Image-X-Institute/IntERAct/Documentation/6DoF/README.md

## **6DoF Platform Documentation**
* Robotic Motion Phantom Release updates                                 -   [RoboticMotionPhantom v2.0.0 Release.pdf](https://github.com/Image-X-Institute/6-DoF-Robotic-Motion-Phantom/blob/main/Documentation/6DoF/RoboticMotionPhantom%20v2.0.0%20Release.pdf)
* Bill of Materials                                                      -   [Bill of Materials.pdf](https://github.com/Image-X-Institute/6-DoF-Robotic-Motion-Phantom/blob/main/Documentation/6DoF/Bill%20of%20materials.pdf)
* UR3 robot specifications                                                -   [UR3 Robot specification](https://www.universal-robots.com/products/ur3-robot/)
* UR16 robot specifications                                               - [UR16 robot specification](https://www.universal-robots.com/products/ur16-robot/)
* CAD drawing of the phantom and tool flange holder                      -   [CAD Drawing of the phantom](https://github.com/Image-X-Institute/6-DoF-Robotic-Motion-Phantom/tree/main/Documentation/CAD%20Drawing%20of%20the%20phantom)
* MODBUS communication protocol                                          -   [MODBUS communication.pdf](https://github.com/Image-X-Institute/6-DoF-Robotic-Motion-Phantom/blob/main/Documentation/6DoF/MODBUS%20communication.pdf) and see [this link](https://www.universal-robots.com/articles/ur/modbus-server/).
* To set up the robotic motion phantom                                  -   [Getting Started UR16.pdf](https://github.com/Image-X-Institute/6-DoF-Robotic-Motion-Phantom/blob/main/Documentation/6DoF/Robotic%20phantom%20controller%20(UR16)%20instructions.pdf).
* To operate the robot using the software package                        -   [Software GUI guide.pdf](https://github.com/Image-X-Institute/6-DoF-Robotic-Motion-Phantom/blob/main/Documentation/6DoF/Software%20GUI%20Guide.pdf). 
* To perform QA tests for Kilovoltage Intrafraction Monitoring (KIM)     -   [KIM QA instructions using the robotic phantom](https://github.com/Image-X-Institute/6-DoF-Robotic-Motion-Phantom/blob/main/Documentation/6DoF/KIM%20QA%20Instructions.pdf)) and the QA analysis codes can be found here: https://github.com/ChandrimaSengupta/KIM-QA-Analysis/tree/main/KIM-QA-Analysis-master
* Tool Configuration: TCP, orientation, payload & center of gravity      -    https://www.youtube.com/watch?v=YnC-ccytJlw

## **Troubleshooting**
* As the IntERAct device (specifically, the 6DoF robot) uses TCP/IP protocol to communicate with the motion control software, Bluetooth devices (e.g. headphones, wireless mouse or keyboard) cannot be connected to the computer when motion control software is in use - this is because the motion control software code loops through all serial port connections to find the component platforms. **Please ensure no devices are connected via Bluetooth when running the motion control software/IntERAct device.**
