Image-X-Institute/IntERAct/Documentation/CAD Drawing of the phantom/README.md

This folder contains CAD designs of the phantom with a detector and without a detector attached to the tool tip of the robot and and the CAD design of the tool flange holder.
