Image-X-Institute/IntERAct/Documentation/6DoF/RoboticMotionPhantom v2.0.0 Release.pdf

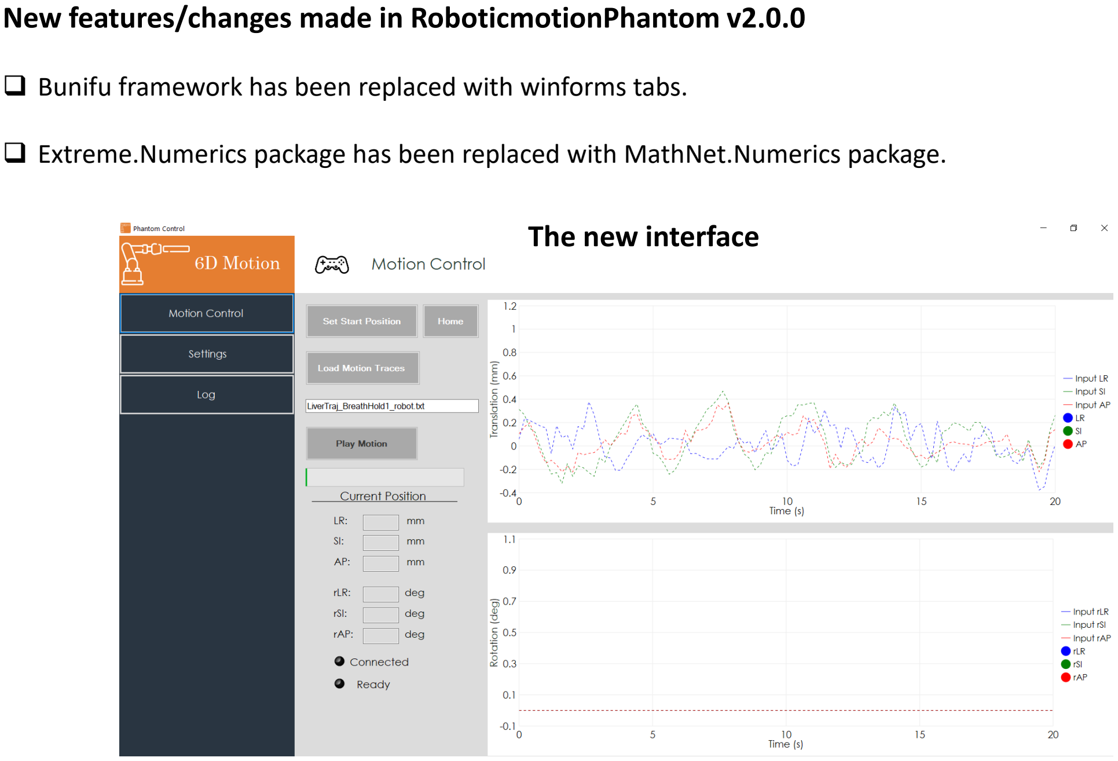
[picture p3: page 1]

New features/changes made in RoboticmotionPhantom v2.0.0

☐ Bunifu framework has been replaced with winforms tabs.

☐ Extreme.Numerics package has been replaced with MathNet.Numerics package.

The new interface

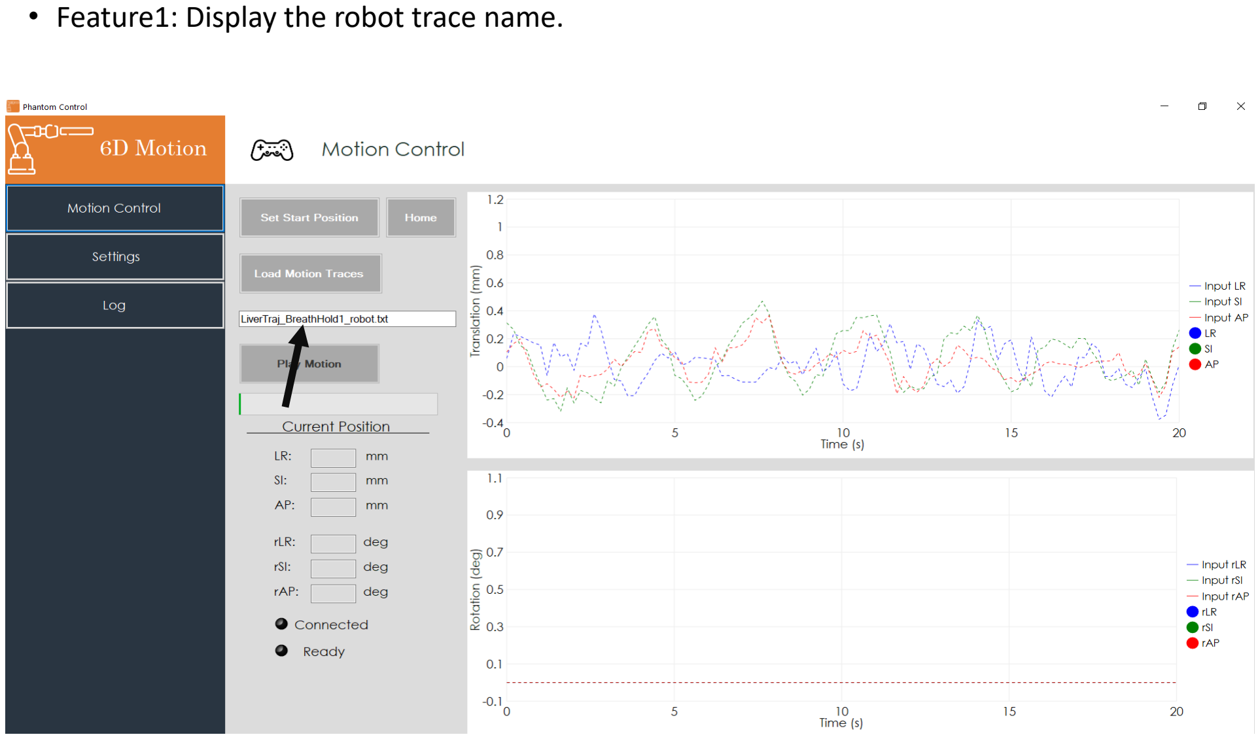
[picture p4: page 2]

- Feature1: Display the robot trace name.

- Feature2: The software will show an error if the Home button was not clicked before loading a new trace.

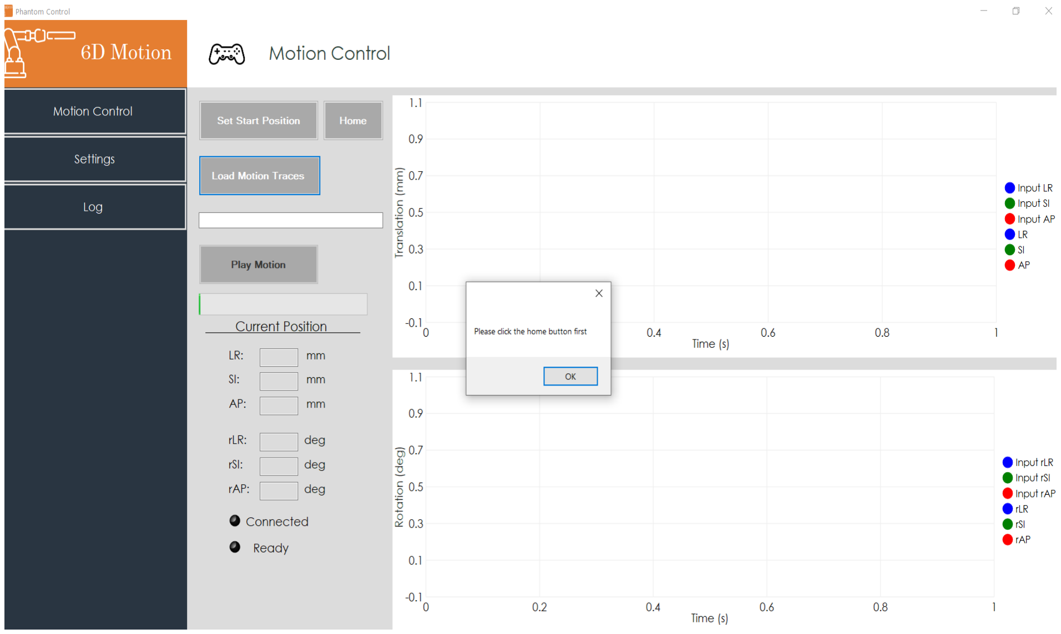
[picture p5: figure]

- Feature3: The software will show an error if the input frequency in the robot trace and in the settings are different.

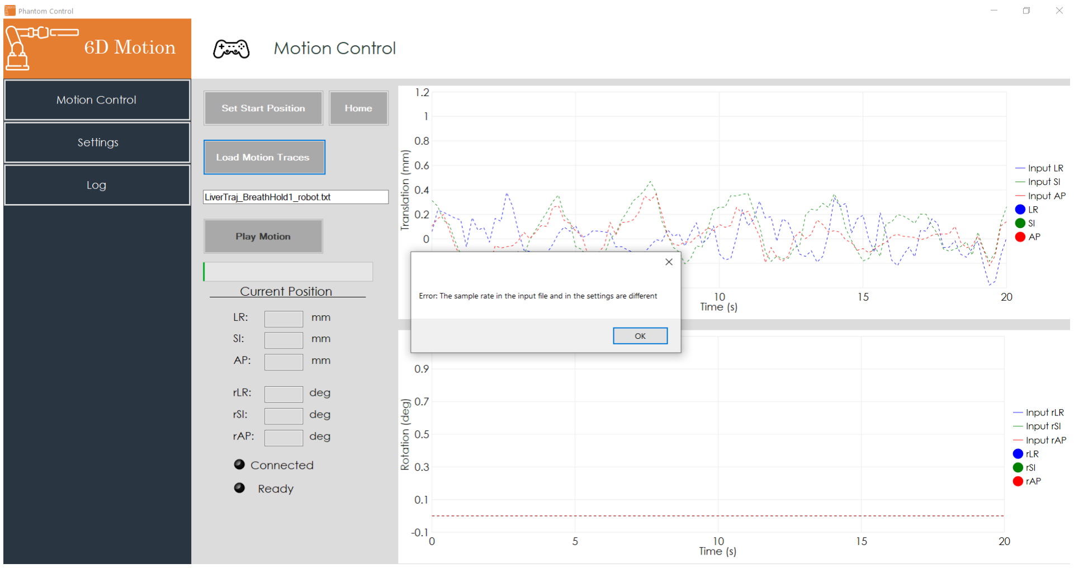
[picture p6: figure]
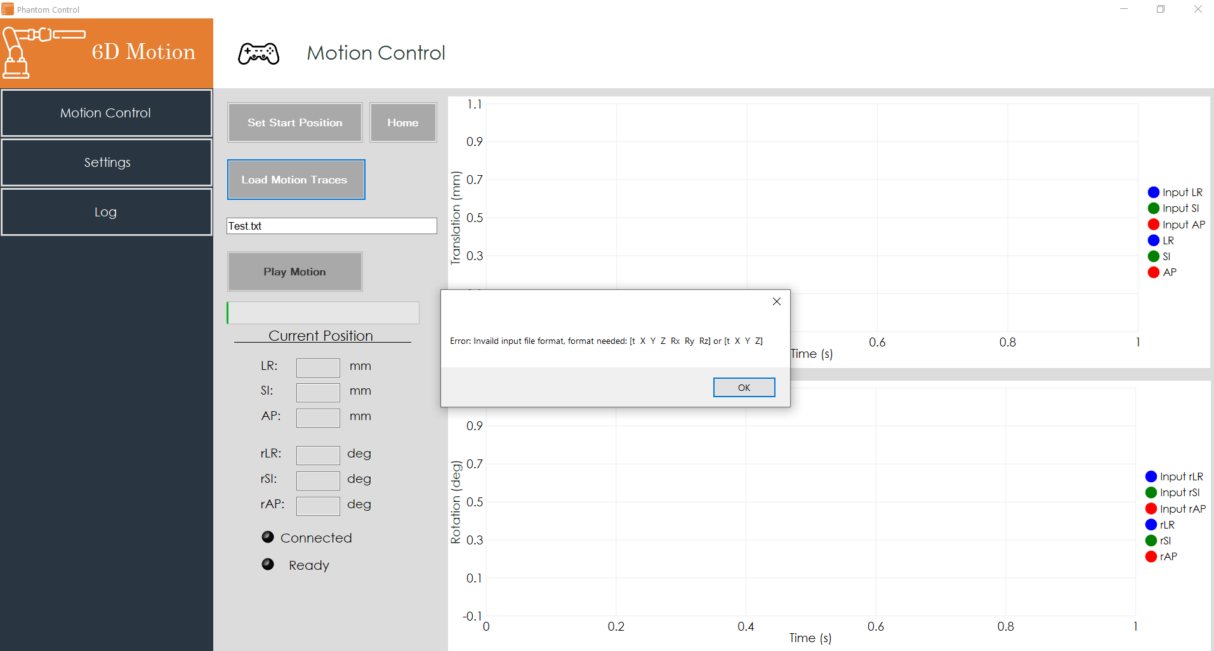
[picture p7: page 5]

- Feature4: The software will show an error if the robot trace file format is wrong.

- Feature5: Only shows the .txt files in the chosen folder.
- Feature 6: Shows the correct percentage of the progress.
- Feature 7: Adds a 5 mm boundary from the maximum magnitude of motion in all the three directions. Any displacement larger than that will stop the robot. This has been added as an additional safety check.
