Image-X-Institute/IntERAct/Documentation/6DoF/Robot Transport Checklist.jpg

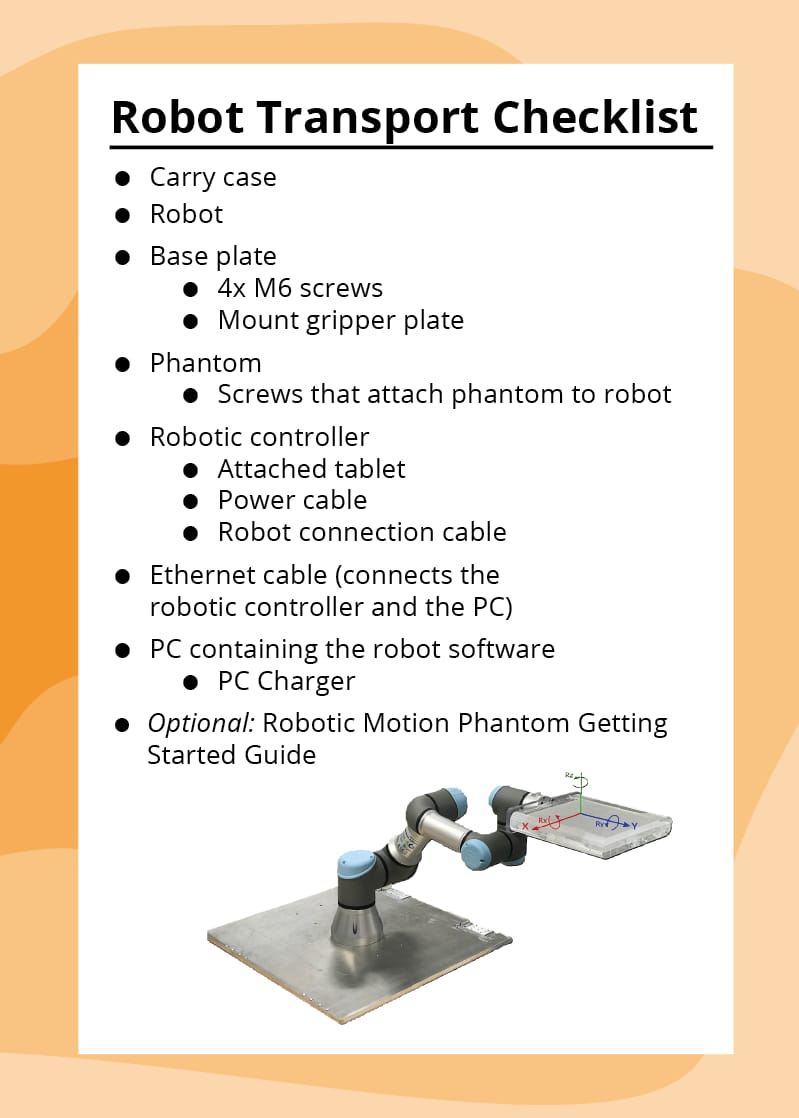
Documentation/6DoF/Robot Transport Checklist.jpg
