Image-X-Institute/IntERAct/Traces/LARK & SABR TRACES/13.02.24 LARK & SABR/LIGHT_SABR_traces/TraceImages/High_motion_Internal.jpg

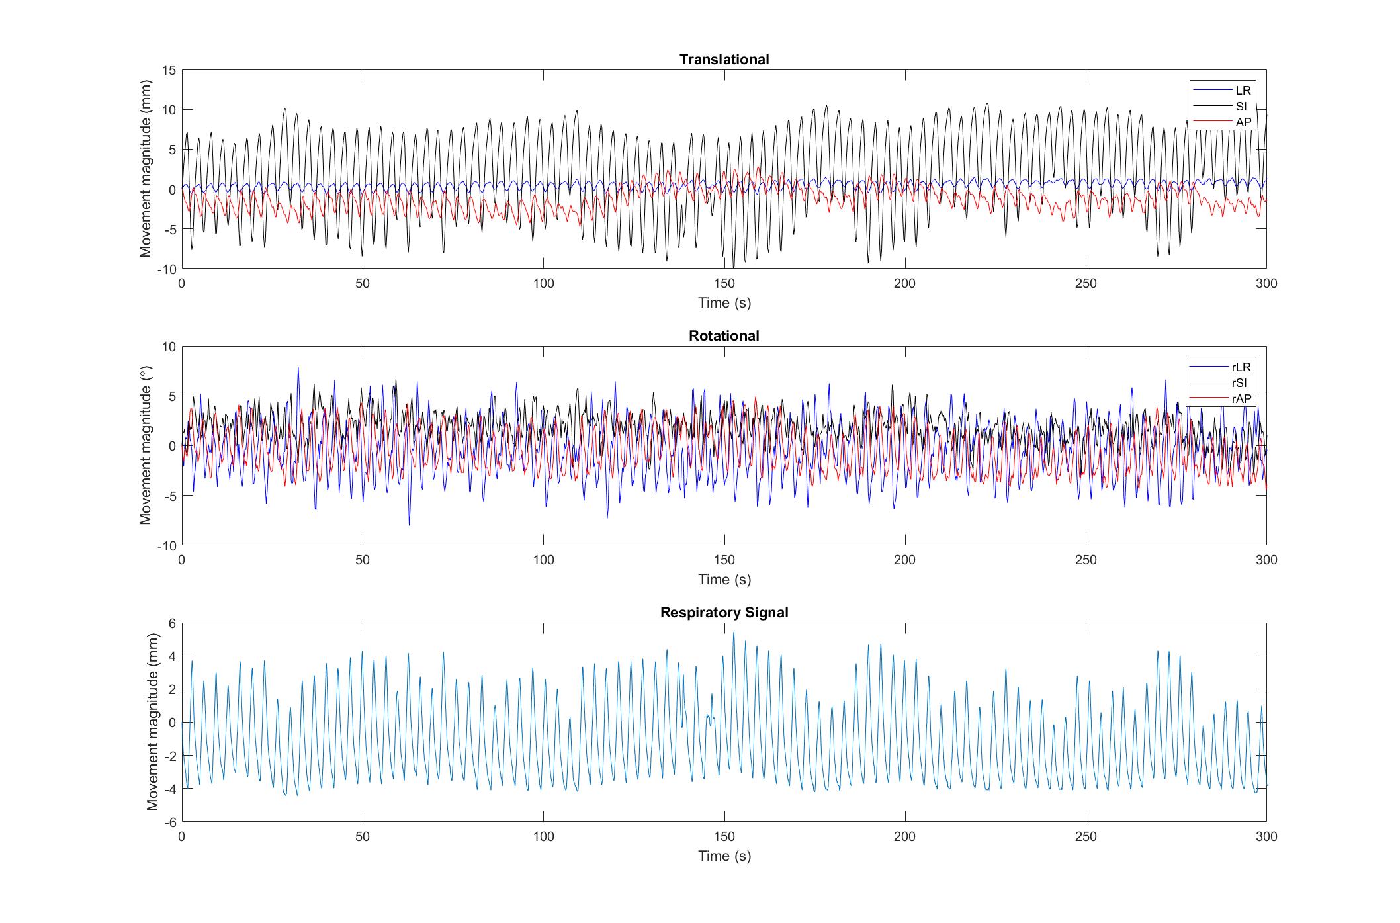
Traces/LARK & SABR TRACES/13.02.24 LARK & SABR/LIGHT_SABR_traces/TraceImages/High_motion_Internal.jpg
