Image-X-Institute/IntERAct/Traces/LARK & SABR TRACES/13.02.24 LARK & SABR/LIGHT_SABR_traces/TraceImages/Mean_complexity_Internal.jpg

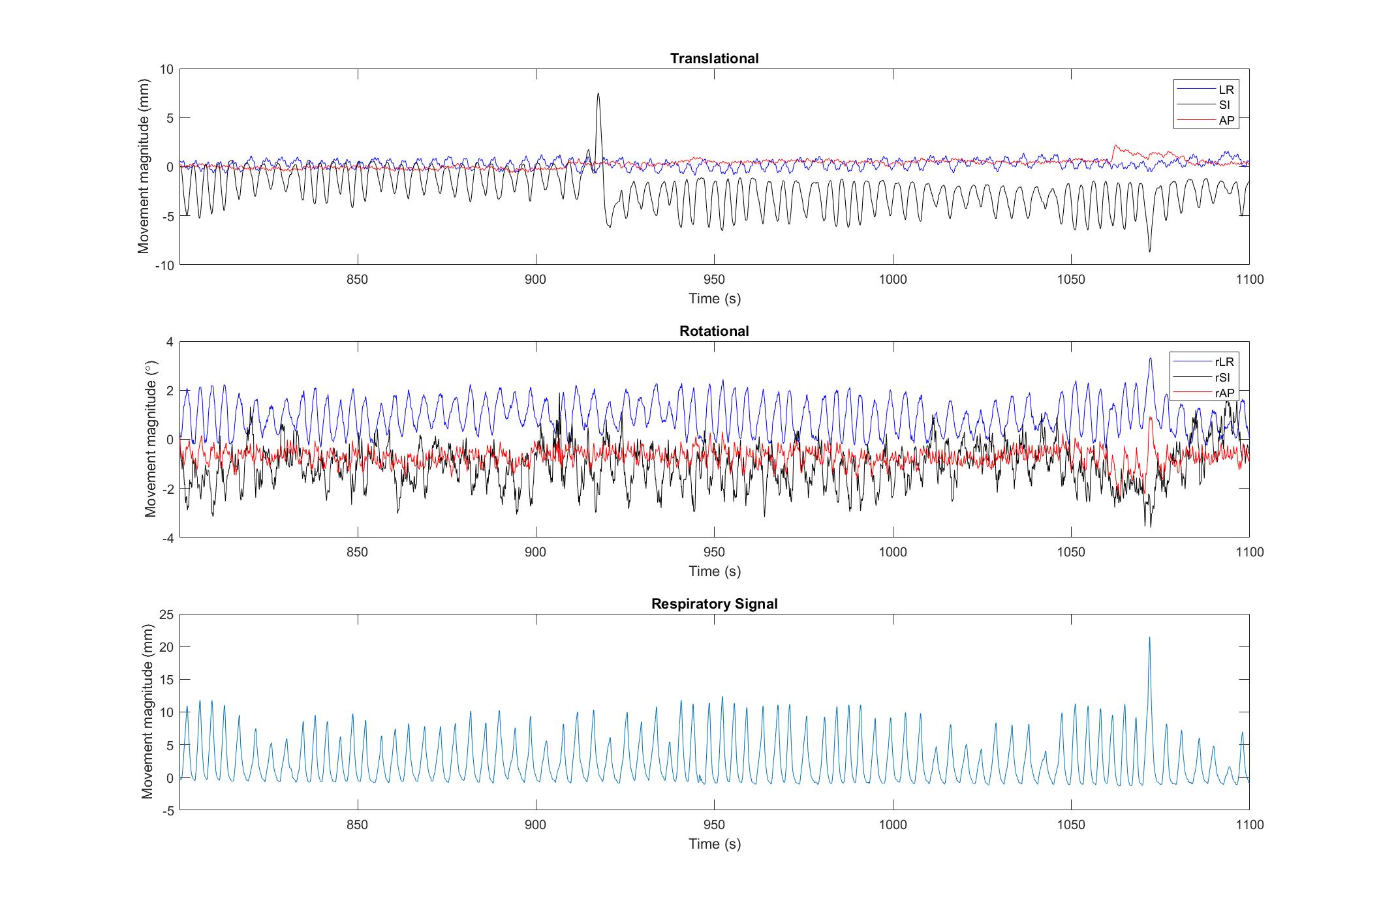
Traces/LARK & SABR TRACES/13.02.24 LARK & SABR/LIGHT_SABR_traces/TraceImages/Mean_complexity_Internal.jpg
