Image-X-Institute/IntERAct/Documentation/6DoF/Bill of materials.pdf

# 6D Robot Motion Phantom

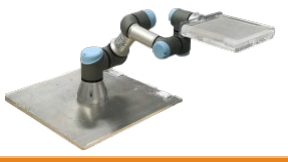
[picture p19: figure]

Assembly Name : | [42]
Assembly Number :
Assembly Revision :
Approval Date :
| Part Count : | 7
| Total Cost :
Part # | Part Name | Description | Qty | Units | Picture | Unit Cost | Cost

1 UR3 Robot UR Robotic Arm 1

2 Gripper attachment PMMA attachment between the UR3 end effector phantom 1

Aluminium plate attaches to treatment couch and fixes 3 Base plate 1 UR3 robot on the surface of the plate | $ -
PMMA block with three 4 Marker phantom embedded gold markers 1 (No detector insert) (geometry configuration) | $ -
PMMA block with three embedded gold markers and a 5 Marker phantom detector insert for the Magic 1 (with detector insert) Plate system (dosimetry configuration) | $ -
PMMA case for Magic Plate 6 Magic Plate holder 1 radiation detector system (dosimetry configuration) | $ -

High spatial resolution 7 Magic Plate 512 radiation detector system 1 (dosimetry configuration)

Total 7
