Image-X-Institute/IntERAct/Documentation/CAD Drawing of the phantom/UR16 2D array phantom/PhantomFrame-Flange.STEP

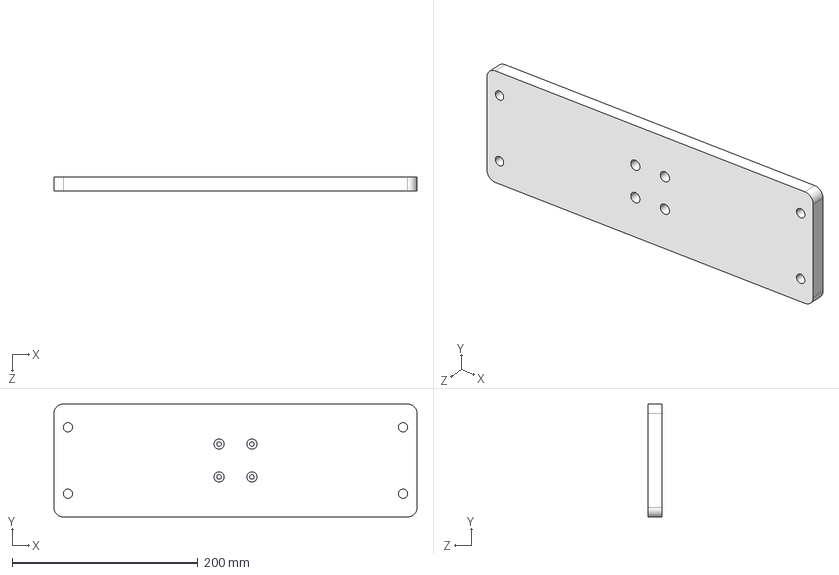
[picture p20: CAD file, 2024-06-12]
Documentation/CAD Drawing of the phantom/UR16 2D array phantom/PhantomFrame-Flange.STEP
390.6 x 121.5 x 15.0 mm
