Image-X-Institute/IntERAct/Documentation/Robotic Motion QA traces/README

This directory provides the traces used for the robotic phantom QA.
