Image-X-Institute/IntERAct/Documentation/Verification/Clinical tests/README.md

This folder shows the results obtained using the 1DoF and 6DoF UR3CB3 in the radiotherapy clinic (Royal North Shore Hospital). The traces that have been tested are in the AP direction and can be found : 
\2_ProjectData\6DoF Robotic Motion Phantom\Chris_tests\LARK - LIGHT SABR
