Image-X-Institute/IntERAct/Documentation/Verification/1D-UR16 (IX Lab)/README.md

This folder shows the results obtained using the 1DoF and 6DoF UR16e in the Image X laboratory in terms of accuracy, reproducibility and time synchronization. The traces that have been tested are in the AP direction and can be found : 
\2_ProjectData\6DoF Robotic Motion Phantom\Chris_tests\LARK - LIGHT SABR
