Image-X-Institute/IntERAct/Documentation/Verification/README.md

This folder contains the results of the combined system obtained in the clinic (Royal North Shore Hospital)  and in the Image X Institute laboratory.

* The folder [1D-UR16](https://github.com/Image-X-Institute/6-DoF-Robotic-Motion-Phantom/tree/main/Documentation/Verification/1D-UR16%20(IX%20Lab)) shows the results of the combined system (1DoF and 6DoF UR16e platforms in the Image X Institute Laboratory).
