Image-X-Institute/IntERAct/Traces/LARK & SABR TRACES/13.02.24 LARK & SABR/LARK_traces/1.test_sine_motion_trace.txt

0 0 0 0 0 0 0
0.2 -0.0167337192274157 -0.0135406031738294 -0.142888446929382 0.173762840517577 -0.434407101293942 -0.695051362070307
0.4 -0.0664257544384212 -0.0180922056302548 -0.300986297916216 0.342238956334464 -0.85559739083616 -1.36895582533786
0.6 -0.147564228242 -0.0135163251192019 -0.469483434689826 0.500302471053198 -1.25075617763299 -2.00120988421279
0.8 -0.257680507112387 4.78174508016238e-05 -0.643253341291315 0.643144311082138 -1.60786077770534 -2.57257724432855
1 -0.393424309425975 0.0221875338009792 -0.817009078034787 0.766418521430428 -1.91604630357607 -3.06567408572171
1.2 -0.550665637592259 0.052229224300097 -0.985464136351482 0.866374491145431 -2.16593622786358 -3.46549796458172
1.4 -0.724620432999455 0.0892588721955567 -1.1434932805172 0.939971065441121 -2.3499276636028 -3.75988426176448
1.6 -0.909996130730099 0.132149852521954 -1.28628848266245 0.98496907266229 -2.46242268165573 -3.93987629064916
1.8 -1.10115268555253 0.179597209602614 -1.40950520675139 0.999999450956881 -2.4999986273922 -3.99999780382752
2 -1.29227416998153 0.230157360253046 -1.5093945908476 0.984604901906232 -2.46151225476558 -3.93841960762493
2.2 -1.4775457235466 0.282292014718558 -1.58291750602877 0.939253803803882 -2.34813450950971 -3.75701521521553
2.4 -1.65133046959651 0.334414979053979 -1.62783702171414 0.865325961272194 -2.16331490318049 -3.46130384508878
2.6 -1.80834101695597 0.384940414985691 -1.64278646415224 0.765070624783921 -1.9126765619598 -3.06028249913568
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
7.6 -0.0680128053252411 -0.0180892774048094 -0.304928423839922 0.346174405510926 -0.865436013777316 -1.38469762204371
7.8 -0.149879354471977 -0.0132949396980671 -0.473613104018164 0.503927351891758 -1.25981837972939 -2.01570940756703
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
