Image-X-Institute/IntERAct/Traces/LARK & SABR TRACES/13.02.24 LARK & SABR/LARK_traces/1.test_sine_motion_trace_resp.txt

0 0.499314767377287
0.2 0.48717193323794
0.4 0.460206920287174
0.6 0.419240137535319
0.8 0.365517997055501
1 0.300674991966059
1.2 0.226683967068861
1.4 0.145796095156596
1.6 0.0604723852065058
1.8 -0.0266911936800532
2 -0.113042694492273
2.2 -0.195954877649322
2.4 -0.272905144617595
2.6 -0.341552287829964
2.8 -0.399807721795008
3 -0.445899028193743
3.2 -0.478423881607803
3.4 -0.496392715191836
3.6 -0.499258828189405
3.8 -0.486935019272921
4 -0.459796239639147
4.2 -0.418668185140023
4.4 -0.364802174532562
4.6 -0.299837078175687
4.8 -0.225749455491247
5 -0.144793418254203
5.2 -0.059432049367988
5.4 0.0277375362950149
5.6 0.114063208968161
5.8 0.196918514890306
6 0.273782586014534
6.2 0.342316837277448
6.4 0.400436117918876
6.6 0.446372152077084
6.8 0.478727338482937
7 0.496517272400316
7.2 0.499200696085132
7.4 0.486695966521915
7.6 0.459383539407982
7.8 0.418094393810142
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
