Image-X-Institute/IntERAct/Traces/LARK & SABR TRACES/13.02.24 LARK & SABR/LARK_traces/test_sine_motion_trace.txt

0 0 0 0 0 -0 -0
0.2 -1.17136034591906 -0.947842222168063 -10.0021912850568 0.173762840517577 -0.434407101293942 -0.695051362070307
0.4 -4.64980281068947 -1.26645439411783 -21.0690408541351 0.342238956334464 -0.85559739083616 -1.36895582533786
0.6 -10.32949597694 -0.946142758344131 -32.8638404282878 0.500302471053198 -1.25075617763299 -2.00120988421279
0.8 -18.0376354978671 0.00334722155611544 -45.0277338903921 0.643144311082138 -1.60786077770534 -2.57257724432855
1 -27.5397016598182 1.55312736606854 -57.1906354624351 0.766418521430428 -1.91604630357607 -3.06567408572171
1.2 -38.5465946314581 3.65604570100679 -68.9824895446037 0.866374491145431 -2.16593622786358 -3.46549796458172
1.4 -50.7234303099619 6.24812105368898 -80.044529636204 0.939971065441121 -2.3499276636028 -3.75988426176448
1.6 -63.6997291511069 9.25048967653678 -90.0401937863718 0.98496907266229 -2.46242268165573 -3.93987629064916
1.8 -77.0806879886774 12.571804672183 -98.6653644725973 0.999999450956881 -2.4999986273922 -3.99999780382752
2 -90.4591918987068 16.1110152177132 -105.657621359332 0.984604901906232 -2.46151225476558 -3.93841960762493
2.2 -103.428200648262 19.7604410302991 -110.804225422014 0.939253803803882 -2.34813450950971 -3.75701521521553
2.4 -115.593132871756 23.4090485337785 -113.94859151999 0.865325961272194 -2.16331490318049 -3.46130384508878
2.6 -126.583871186918 26.9458290489984 -114.995052490657 0.765070624783921 -1.9126765619598 -3.06028249913568
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
7.6 -4.76089637276687 -1.26624941833665 -21.3449896687946 0.346174405510926 -0.865436013777316 -1.38469762204371
7.8 -10.4915548130384 -0.930645778864694 -33.1529172812715 0.503927351891758 -1.25981837972939 -2.01570940756703
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
