Image-X-Institute/IntERAct/Traces/LARK & SABR TRACES/13.02.24 LARK & SABR/LARK_traces/test_sine_motion_trace_2_resp.txt

0 4.99314767377287
0.2 4.8717193323794
0.4 4.60206920287174
0.6 4.19240137535319
0.8 3.65517997055501
1 3.00674991966059
1.2 2.26683967068861
1.4 1.45796095156596
1.6 0.604723852065058
1.8 -0.266911936800531
2 -1.13042694492273
2.2 -1.95954877649322
2.4 -2.72905144617595
2.6 -3.41552287829964
2.8 -3.99807721795008
3 -4.45899028193743
3.2 -4.78423881607803
3.4 -4.96392715191836
3.6 -4.99258828189405
3.8 -4.86935019272921
4 -4.59796239639147
4.2 -4.18668185140023
4.4 -3.64802174532562
4.6 -2.99837078175687
4.8 -2.25749455491247
5 -1.44793418254203
5.2 -0.59432049367988
5.4 0.277375362950149
5.6 1.14063208968161
5.8 1.96918514890306
6 2.73782586014534
6.2 3.42316837277448
6.4 4.00436117918876
6.6 4.46372152077083
6.8 4.78727338482937
7 4.96517272400316
7.2 4.99200696085132
7.4 4.86695966521915
7.6 4.59383539407982
7.8 4.18094393810142
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
