Image-X-Institute/IntERAct/Traces/LARK & SABR TRACES/LARK traces/LARK traces/Test_motion_091.txt

0 -0.7783 -2.7497 0.5375 0 0 0.0393
0.2 -0.7783 -2.7497 0.5375 -0.2696 -1.2435 0.9375
0.4 -0.5646 -2.0071 0.2912 -0.2696 -1.2435 0.9375
0.6 -0.3168 -0.878 0.172 -0.0708 -0.9534 0.5873
0.8 -0.2738 -0.6536 0.172 -0.0678 -0.8234 0.4554
1 -0.2703 -0.6144 0.2324 0.0824 -0.5794 0.3599
1.2 -0.2738 -0.6144 0.2561 0.1006 -0.4339 0.2225
1.4 -0.3088 -0.8173 0.4334 0.1006 -0.2726 0.1611
1.6 -0.8401 -1.9739 1.1789 -0.1778 1.1657 -0.2309
1.8 -1.3335 -4.0136 1.6159 -0.7465 1.1657 -0.2309
2 -1.9602 -6.2028 2.2341 -1.2945 1.1226 0.035
2.2 -2.4838 -8.1095 2.5304 -1.8336 1.1038 0.3993
2.4 -3.0084 -9.9501 3.1279 -2.2089 1.1038 0.3993
2.6 -3.3534 -11.2663 3.7269 -2.2089 1.3907 0.4297
2.8 -3.3534 -11.2663 3.7269 -2.1741 1.3907 0.4297
3 -2.876 -9.9757 3.1763 -1.5789 0.3338 0.9293
3.2 -2.362 -7.7462 2.3006 -1.207 -0.1974 0.9293
3.4 -1.7443 -5.6807 1.6411 -0.7416 -0.1974 0.6538
3.6 -1.2737 -3.7728 1.1845 -0.1528 -0.1196 0.1891
3.8 -1.0877 -2.818 0.9058 -0.0947 0.0961 0.037
4 -0.8769 -1.985 0.8867 0.1883 0.6904 -0.6208
4.2 -0.7464 -1.496 0.7867 0.2808 0.9258 -0.8223
4.4 -0.6725 -0.9401 0.7867 0.4372 1.4977 -1.0987
4.6 -0.5961 -0.5502 0.8077 0.4372 1.7201 -1.2596
4.8 -0.5961 -0.5502 0.8352 0.4245 1.8573 -1.2596
5 -0.6476 -0.968 1.0002 0.2752 1.8573 -1.2396
5.2 -1.0095 -2.4128 1.2657 -0.2806 1.5146 -0.7118
5.4 -1.1738 -3.2263 1.4317 -0.4973 1.4645 -0.4049
5.6 -1.4399 -4.4493 1.6846 -0.7364 0.7731 -0.1656
5.8 -2.0801 -7.3234 2.2898 -1.5694 0.4387 0.7677
6 -2.7609 -9.5617 2.7579 -1.8956 0.3428 1.2429
6.2 -3.1394 -11.0162 3.0505 -2.3535 -0.2267 1.8998
6.4 -3.2829 -11.3719 3.2318 -2.3535 -0.2267 1.8998
6.6 -3.2829 -11.3719 3.2318 -1.8703 0.6451 1.1282
6.8 -2.9485 -9.6429 2.8424 -1.4093 0.6451 0.7443
7 -2.5215 -7.5998 2.4 -0.9529 0.3427 0.3685
7.2 -1.9935 -5.7835 1.9027 -0.8262 0.0012 0.3685
7.4 -1.2852 -3.7886 1.3686 -0.6907 -0.33 0.4455
7.6 -0.9715 -2.7623 1.1349 -0.5514 -0.449 0.4669
7.8 -0.4798 -1.9766 0.7783 -0.5246 -0.449 0.5051
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
