Image-X-Institute/IntERAct/Traces/LARK & SABR TRACES/LARK traces/LARK traces/Test_motion_091_resp.txt

0 0
0.2 0
0.4 -0.2212
0.6 -0.4245
0.8 -0.5076
1 -0.6533
1.2 -0.6533
1.4 -0.5948
1.6 -0.1669
1.8 0.2568
2 0.7436
2.2 1.3959
2.4 1.8138
2.6 2.2245
2.8 2.2245
3 1.8323
3.2 1.3671
3.4 0.8845
3.6 0.4042
3.8 0.0846
4 -0.0885
4.2 -0.2784
4.4 -0.3911
4.6 -0.5054
4.8 -0.5054
5 -0.4425
5.2 -0.092
5.4 0.0973
5.6 0.5065
5.8 1.1418
6 1.7466
6.2 2.0595
6.4 2.202
6.6 2.202
6.8 1.757
7 1.3504
7.2 0.7948
7.4 0.4539
7.6 0.1281
7.8 -0.0488
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
