Image-X-Institute/IntERAct/Traces/LARK & SABR TRACES/LARK traces/LARK traces/Test_motion_101.txt

0 0 0 0 0 0 0
0.2 -0.0005 -0.0717 0.0575 0.119 -0.0199 0.0008
0.4 -0.001 -0.1434 0.115 0.2379 -0.0398 0.0016
0.6 -0.0014 -0.2151 0.1725 0.3569 -0.0598 0.0024
0.8 -0.0019 -0.2869 0.2301 0.4759 -0.0797 0.0032
1 -0.0019 -0.3586 0.2876 0.5949 -0.0996 0.0032
1.2 0.0246 -1.1921 0.5222 0.5949 -0.4466 -0.2713
1.4 0.0583 -2.3599 0.7882 0.5729 -0.734 -0.5029
1.6 0.0955 -3.9793 1.049 0.4665 -0.7349 -0.5029
1.8 0.1547 -5.5125 1.3946 0.1268 -0.9016 -0.4104
2 0.2213 -7.0107 1.7575 -0.3476 -1.1482 -0.2449
2.2 0.2405 -8.6684 1.893 -0.5574 -1.1514 -0.1192
2.4 0.257 -10.3523 2.0195 -0.596 -1.2568 -0.0105
2.6 0.2603 -11.775 2.1697 -0.596 -2.462 0.0714
2.8 0.261 -12.3552 2.2423 -0.454 -2.9094 0.2908
3 0.3235 -13.4015 2.5265 -0.454 -2.9094 0.4085
3.2 0.3528 -13.4015 2.5496 -0.3951 -2.6468 0.4578
3.4 0.3808 -12.6837 2.5496 -0.352 -1.9807 0.5193
3.6 0.3808 -11.9964 2.5197 0.2096 -1.9807 0.7666
3.8 0.3718 -11.6886 2.3712 0.8823 -2.1973 1.2836
4 0.2808 -10.6384 2.062 0.8823 -2.1973 1.2836
4.2 0.0999 -9.1604 1.5369 0.0833 -1.1082 0.9883
4.4 0.0529 -4.8782 1.2143 -0.1109 -1.0333 -1.7764
4.6 -0.0813 -3.6563 1.0273 -0.1109 -0.5702 -1.7764
4.8 -0.0813 -2.7258 0.8656 -0.7785 0.0446 -1.7077
5 -0.2156 -1.7953 0.5169 -1.446 0.6593 -1.639
5.2 -0.3498 -0.8648 0.1681 -2.1136 1.2741 -1.5703
5.4 -0.4841 0.0657 -0.1806 -2.7811 1.8888 -1.5015
5.6 -0.4841 0.6303 -0.3382 -2.7811 1.8888 -1.4328
5.8 -0.4564 0.6303 -0.3382 -1.174 1.6175 -0.2508
6 -0.1608 0.1502 0.0401 1.7982 0.0685 0.446
6.2 -0.0526 -0.0283 0.2013 2.1426 -0.2163 0.446
6.4 0.0057 -0.0409 0.304 2.1426 -0.2163 0.1924
6.6 0.0736 -0.5054 0.4185 1.9652 -0.2163 -0.6177
6.8 0.0803 -1.269 0.5579 1.9652 -0.3795 -0.936
7 0.1037 -2.0605 0.6385 1.9674 -0.6002 -0.936
7.2 0.2218 -3.6321 1.0499 2.0115 -1.4912 -0.8714
7.4 0.3013 -5.099 1.3647 2.0115 -2.2133 -0.8266
7.6 0.3013 -6.2501 1.5707 1.5526 -2.2437 -0.4183
7.8 0.3246 -7.4399 1.7793 1.1139 -3.0018 -0.0926
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
