Image-X-Institute/IntERAct/Traces/LARK & SABR TRACES/LARK traces/LARK traces/Test_motion_101_resp.txt

0 0
0.2 0.1045
0.4 0.2089
0.6 0.3134
0.8 0.4178
1 0.5223
1.2 0.7679
1.4 1.0496
1.6 1.3533
1.8 1.599
2 1.8287
2.2 2.1964
2.4 2.5736
2.6 2.7936
2.8 2.9105
3 3.1742
3.2 3.1742
3.4 2.8772
3.6 2.5605
3.8 2.3866
4 1.9472
4.2 1.6414
4.4 1.4677
4.6 1.2648
4.8 1.0541
5 0.8435
5.2 0.6328
5.4 0.4221
5.6 0.2115
5.8 0.0657
6 0.0657
6.2 0.1207
6.4 0.3742
6.6 0.7503
6.8 0.996
7 1.2037
7.2 1.4527
7.4 1.7945
7.6 1.9535
7.8 2.2797
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
