Image-X-Institute/IntERAct/Traces/LARK & SABR TRACES/LARK traces/LARK traces/Test_motion_103.txt

0 0 0 0 0 0 0
0.2 0.0342 -1.2477 -0.0015 0.0439 -0.0781 0.2707
0.4 0.0685 -2.4954 -0.0015 0.0878 -0.1561 0.5414
0.6 0.1521 -4.0132 0.0525 0.7054 -0.2226 0.7073
0.8 0.3023 -5.8966 0.1854 2.0993 -0.2735 0.7314
1 0.485 -8.0316 0.6243 2.1666 -1.4789 1.0689
1.2 0.6519 -10.023 1.0258 2.1686 -2.4171 1.4801
1.4 0.7827 -11.6987 1.2412 2.1666 -2.4171 1.8236
1.6 0.886 -13.0717 1.3482 2.5856 -2.4904 1.8394
1.8 0.8904 -13.0717 1.4617 2.468 -2.8453 2.322
2 0.8909 -12.5115 1.4617 2.468 -2.8453 2.601
2.2 0.8904 -11.4365 1.449 0.5478 -1.2474 2.9198
2.4 0.7407 -10.612 0.7988 -2.6029 0.409 3.0341
2.6 0.661 -9.5962 0.6559 -2.9128 0.4132 3.1852
2.8 0.5189 -8.4244 0.3627 -3.7977 1.1208 3.1852
3 0.3739 -7.3737 -0.0744 -4.9432 1.5154 3.0861
3.2 0.279 -6.4681 -0.1485 -4.9432 1.5355 3.0861
3.4 0.2068 -5.2589 -0.2295 -5.1406 1.9514 3.1507
3.6 0.0288 -4.5098 -0.6947 -7.3637 3.4141 3.5045
3.8 -0.013 -4.2273 -0.6947 -7.923 4.1427 3.6035
4 -0.013 -3.9934 -0.6021 -7.923 4.6001 3.6769
4.2 0.1281 -3.3938 -0.347 -7.7883 4.6001 3.6769
4.4 0.2096 -1.3907 -0.0861 -2.6325 2.8856 2.2133
4.6 0.2096 -1.3862 0.156 0.2598 1.5663 0.9949
4.8 0.2548 -1.3862 0.156 0.2598 0.4689 0.2371
5 0.3085 -2.2913 0.1952 -0.2967 0.3837 0.1963
5.2 0.3085 -3.577 0.2342 -0.2967 0.121 0.0908
5.4 0.3842 -5.004 0.3024 -0.2967 0.0242 0.0908
5.6 0.3916 -5.9287 0.4282 -1.1156 0.0242 0.2666
5.8 0.4497 -8.1561 0.6662 -2.0234 0.3231 0.9167
6 0.6202 -10.2245 0.765 -2.7426 0.3231 1.4197
6.2 0.8042 -10.9049 0.8889 -2.7426 0.2976 1.7643
6.4 0.8042 -12.0704 1.0031 -1.8108 -0.7993 2.2845
6.6 0.8572 -12.0704 1.0031 -1.7053 -0.9669 2.5421
6.8 0.8249 -11.5879 0.9139 -0.0268 -1.7115 3.0894
7 0.8249 -10.8657 0.9085 2.5961 -2.8266 3.8342
7.2 0.8237 -10.3489 0.9085 3.8716 -2.9393 4.0273
7.4 0.7922 -10.1665 0.9344 3.8716 -2.9393 4.1135
7.6 0.7178 -9.7128 0.9344 3.8708 -2.4967 4.1135
7.8 0.6345 -8.1145 0.7274 2.2462 -1.0185 3.7312
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
