Image-X-Institute/IntERAct/Traces/LARK & SABR TRACES/LARK traces/LARK traces/Test_motion_103_resp.txt

0 0
0.2 0.275
0.4 0.5499
0.6 0.8063
0.8 1.0375
1 1.389
1.2 1.7999
1.4 2.228
1.6 2.4035
1.8 2.4035
2 2.1981
2.2 1.8956
2.4 1.6107
2.6 1.4262
2.8 1.1055
3 0.9424
3.2 0.7498
3.4 0.4592
3.6 0.2467
3.8 0.1871
4 0.1309
4.2 0.0327
4.4 -0.0872
4.6 -0.0872
4.8 0.2623
5 0.5823
5.2 0.8478
5.4 1.1342
5.6 1.3028
5.8 1.6278
6 1.8642
6.2 1.9192
6.4 2.125
6.6 2.125
6.8 1.9234
7 1.6565
7.2 1.4929
7.4 1.4445
7.6 1.4187
7.8 1.0257
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
