Image-X-Institute/IntERAct/Traces/LARK & SABR TRACES/LARK traces/LARK traces/Test_motion_112.txt

0 0 0 0 0 0 0
0.2 -0.963 -2.5443 -1.2343 -0.0665 0.0666 0.0146
0.4 -1.926 -5.0887 -2.4685 -0.1331 0.1332 0.0292
0.6 -2.889 -7.633 -3.7028 -0.1996 0.1998 0.0292
0.8 -2.9006 -8.327 -4.6819 -0.3247 0.2746 -0.0609
1 -2.9006 -8.327 -4.9713 -0.6082 0.3715 -0.488
1.2 -2.6149 -7.7858 -5.4176 -0.7157 0.3791 -0.6167
1.4 -2.2887 -7.247 -5.705 -0.8581 0.3791 -0.8278
1.6 -1.9522 -6.6237 -5.891 -0.8581 0.3791 -0.9661
1.8 -1.6251 -6.0467 -5.9744 -0.8171 0.371 -1.1477
2 -1.6251 -6.0467 -5.9744 -0.4677 0.4039 -1.2364
2.2 -1.6869 -6.6343 -5.6564 -0.3364 0.3625 -1.5704
2.4 -2.0761 -7.8268 -4.9759 0.2969 0.219 -1.8034
2.6 -2.2429 -9.2269 -4.4783 0.7604 0.0245 -2.6722
2.8 -3.093 -11.6336 -3.7562 1.6008 -0.2064 -2.8123
3 -4.2744 -14.5434 -3.2547 1.7299 -0.3416 -2.8345
3.2 -5.1165 -16.5751 -2.3911 2.1483 -0.4334 -2.8134
3.4 -5.8009 -18.1507 -1.8524 2.5444 -0.464 -2.8134
3.6 -6.6774 -19.9951 -1.537 2.5444 -0.464 -2.4839
3.8 -6.8376 -19.9951 -1.5077 2.4878 -0.3707 -1.7102
4 -6.8376 -18.3887 -1.5077 2.3417 -0.3525 -1.1294
4.2 -6.0064 -16.1889 -2.244 1.7613 -0.046 -0.9978
4.4 -5.2238 -14.2765 -3.2195 0.9574 0.3087 -0.8415
4.6 -4.4909 -12.4539 -3.9229 0.1631 0.5932 -0.8415
4.8 -3.5415 -10.6295 -4.4446 -0.0582 0.6076 -1.1938
5 -2.4546 -8.4241 -5.3729 -0.459 0.697 -1.1938
5.2 -2.2395 -7.6537 -5.5717 -0.5872 0.697 -1.1938
5.4 -1.5958 -6.3814 -5.6424 -0.5872 0.6581 -1.4692
5.6 -1.5288 -6.3814 -5.6424 -0.3549 0.6479 -1.6487
5.8 -1.5288 -6.9366 -5.226 0.1475 0.4486 -2.0123
6 -1.9819 -8.7636 -4.6416 0.8078 0.2991 -2.5263
6.2 -2.8481 -11.0424 -3.9159 1.3687 0.0979 -2.6715
6.4 -3.646 -13.1465 -3.097 2.153 -0.1854 -2.873
6.6 -4.2616 -15.0323 -2.6307 2.4208 -0.3044 -3.007
6.8 -4.8001 -16.3341 -2.3892 2.5475 -0.3517 -3.007
7 -5.8517 -18.8337 -1.823 2.8428 -0.3531 -2.6987
7.2 -6.4326 -18.8337 -1.823 2.8428 -0.3531 -2.2591
7.4 -6.4326 -17.5802 -1.9096 2.2744 0.0022 -0.7683
7.6 -6.1428 -15.2008 -2.4313 1.6316 0.3851 -0.5995
7.8 -5.0965 -11.9933 -3.3655 0.8732 0.6851 -0.3115
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
