Image-X-Institute/IntERAct/Traces/LARK & SABR TRACES/LARK traces/LARK traces/Test_motion_112_resp.txt

0 0
0.2 0
0.4 -0.3214
0.6 -0.6429
0.8 -0.9556
1 -1.2447
1.2 -1.5338
1.4 -1.806
1.6 -2.0997
1.8 -2.4134
2 -2.4661
2.2 -2.4661
2.4 -2.1071
2.6 -1.4558
2.8 -0.5865
3 0.6673
3.2 1.5377
3.4 2.3657
3.6 3.1704
3.8 3.1704
4 2.8164
4.2 1.931
4.4 1.0637
4.6 0.1214
4.8 -0.6669
5 -1.2933
5.2 -1.514
5.4 -1.8736
5.6 -2.0888
5.8 -2.0888
6 -1.451
6.2 -0.5247
6.4 0.3262
6.6 1.2196
6.8 1.845
7 2.9455
7.2 2.9455
7.4 2.5493
7.6 1.476
7.8 0.172
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
