Image-X-Institute/IntERAct/Traces/LARK & SABR TRACES/LARK traces/LARK traces/Test_motion_113.txt

0 0 0 0 0 0 -0
0.2 0.1745 0.3367 0.1515 -0.0087 -0.2072 -0.2504
0.4 0.3489 0.6734 0.303 -0.0175 -0.4144 -0.5009
0.6 0.5234 0.6845 0.4545 -0.0175 -0.6216 -0.7513
0.8 0.5234 0.6845 0.7407 0.0617 -0.7902 -0.9173
1 0.4691 -0.0383 1.1077 0.2077 -0.9357 -1.0302
1.2 0.0321 -2.0103 1.6209 0.6357 -1.0071 -1.0302
1.4 -0.3303 -3.937 2.2594 0.92 -1.1243 -0.9717
1.6 -0.6658 -5.7421 2.872 1.1067 -1.2275 -0.8566
1.8 -1.1108 -7.4177 3.1988 1.3791 -1.2275 -0.7448
2 -1.5753 -9.4204 3.7166 2.0163 -1.038 -0.3948
2.2 -2.1135 -11.2591 4.0326 2.9361 -0.9736 -0.1279
2.4 -2.1879 -12.3893 4.6763 3.4624 -0.8035 0.0059
2.6 -2.4891 -13.3428 4.8428 3.914 -0.8035 0.0737
2.8 -2.6684 -14.0672 5.03 4.3712 -0.4834 0.2541
3 -2.8771 -15.3353 5.4461 4.6747 -0.4834 0.2541
3.2 -2.9062 -15.8956 5.8387 4.8757 -0.5735 0.2541
3.4 -2.9062 -16.718 6.2093 5.3804 -0.5988 0.3081
3.6 -3.1917 -17.6534 6.4141 5.3804 -0.5735 0.3804
3.8 -3.3348 -17.9662 6.424 5.2714 -0.5849 0.416
4 -3.3348 -17.9662 6.5041 5.2563 -0.5494 0.4304
4.2 -3.2505 -17.8817 6.5041 5.201 -0.5704 0.416
4.4 -3.2505 -17.7795 6.4145 5.0312 -0.5704 0.3716
4.6 -3.3277 -17.7479 6.3322 4.9285 -0.5704 0.3716
4.8 -3.3277 -17.6515 6.3025 4.8825 -0.3512 0.5763
5 -3.2193 -17.4587 6.2874 4.8797 -0.3512 0.6684
5.2 -3.1567 -17.3756 6.2677 4.3633 -0.3542 0.7037
5.4 -3.1567 -17.1546 6.1444 3.957 -0.3542 0.7235
5.6 -3.0567 -16.8709 6.0579 3.8286 -0.2019 0.8074
5.8 -2.959 -16.4008 5.9066 3.6278 -0.0865 0.9164
6 -2.959 -16.3832 5.8732 3.2811 0.0797 0.9813
6.2 -2.9907 -16.0351 5.7454 3.277 0.1064 1.0162
6.4 -2.9907 -15.6911 5.6388 3.1843 0.2022 1.2964
6.6 -2.8428 -14.7685 5.3458 2.7314 0.3307 1.4124
6.8 -2.6322 -13.726 5.0047 2.5688 0.5366 1.8869
7 -2.6167 -12.4404 4.6518 2.3746 0.5946 2.0006
7.2 -2.4288 -11.026 4.2319 2.3746 0.6551 2.0014
7.4 -2.0469 -9.6176 3.7431 2.544 0.7293 2.0006
7.6 -1.5969 -8.1736 3.2061 2.6655 0.7941 2.0177
7.8 -1.3957 -6.9228 2.8276 2.6655 0.8929 2.3458
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
