Image-X-Institute/IntERAct/Traces/LARK & SABR TRACES/LARK traces/LARK traces/Test_motion_113_resp.txt

0 0
0.2 0
0.4 -0.136
0.6 -0.2074
0.8 -0.2074
1 -0.0223
1.2 0.551
1.4 1.1985
1.6 1.8737
1.8 2.5464
2 3.339
2.2 4.3521
2.4 4.9582
2.6 5.5416
2.8 5.8622
3 6.2344
3.2 6.6119
3.4 7.0672
3.6 7.5861
3.8 7.73
4 7.854
4.2 7.9291
4.4 7.9291
4.6 7.9132
4.8 7.724
5 7.6638
5.2 7.6273
5.4 7.4868
5.6 7.2646
5.8 6.9383
6 6.7054
6.2 6.3589
6.4 5.9261
6.6 5.467
6.8 5.0868
7 4.6131
7.2 4.19
7.4 3.868
7.6 3.4418
7.8 3.096
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
