Image-X-Institute/IntERAct/RealSense verification/point_measurement.csv

Time | Distance
2.218147993087768555e+00 | 4.479848632812500000e+02
2.253974676132202148e+00 | 4.473771972656250000e+02
2.282058000564575195e+00 | 4.477387695312500000e+02
2.314231395721435547e+00 | 4.476943359375000000e+02
2.354307174682617188e+00 | 4.476748046875000000e+02
2.385156393051147461e+00 | 4.476875000000000000e+02
2.417568683624267578e+00 | 4.476367187500000000e+02
2.454412698745727539e+00 | 4.475480957031250000e+02
2.473653078079223633e+00 | 4.477150878906250000e+02
2.521674394607543945e+00 | 4.476914062500000000e+02
2.554671525955200195e+00 | 4.478459472656250000e+02
2.584898948669433594e+00 | 4.476982421875000000e+02
2.622477769851684570e+00 | 4.476225585937500000e+02
2.654633283615112305e+00 | 4.478537597656250000e+02
2.680152654647827148e+00 | 4.476845703125000000e+02
2.712410688400268555e+00 | 4.479414062500000000e+02
2.754630088806152344e+00 | 4.476440429687500000e+02
2.776091098785400391e+00 | 4.478984375000000000e+02
2.808059692382812500e+00 | 4.477507324218750000e+02
2.856715202331542969e+00 | 4.476020507812500000e+02
2.887833595275878906e+00 | 4.476984863281250000e+02
2.919591903686523438e+00 | 4.473950195312500000e+02
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
