Image-X-Institute/IntERAct/RealSense verification/initial_test_Dec_2025/point_measurement.csv

Time | Distance
2.050553083419799805e+00 | 3.323583984375000000e+02
2.078350067138671875e+00 | 3.320351562500000000e+02
2.096840620040893555e+00 | 3.323896484375000000e+02
2.133994579315185547e+00 | 3.317617187500000000e+02
2.152610063552856445e+00 | 3.317617187500000000e+02
2.167623996734619141e+00 | 3.324521484375000000e+02
2.183901071548461914e+00 | 3.324521484375000000e+02
2.201044559478759766e+00 | 3.323369140625000000e+02
2.227983474731445312e+00 | 3.320761718750000000e+02
2.252727031707763672e+00 | 3.320761718750000000e+02
2.267896175384521484e+00 | 3.320048828125000000e+02
2.283558368682861328e+00 | 3.320048828125000000e+02
2.301393747329711914e+00 | 3.324160156250000000e+02
2.315198183059692383e+00 | 3.324160156250000000e+02
2.347185611724853516e+00 | 3.320214843750000000e+02
2.363200664520263672e+00 | 3.324179687500000000e+02
2.395005226135253906e+00 | 3.323662109375000000e+02
2.413085222244262695e+00 | 3.323662109375000000e+02
2.426701545715332031e+00 | 3.324218750000000000e+02
2.442930698394775391e+00 | 3.324218750000000000e+02
2.474669456481933594e+00 | 3.323476562500000000e+02
2.490763425827026367e+00 | 3.323720703125000000e+02
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
