Image-X-Institute/IntERAct/RealSense verification/Testing_1DoF_ImageX_March_2026/point_measurement.csv

Time | Distance
3.629890418052673340e+01 | 5.460590820312500000e+02
3.633014512062072754e+01 | 5.463496093750000000e+02
3.635051727294921875e+01 | 5.460356445312500000e+02
3.639645457267761230e+01 | 5.459685058593750000e+02
3.642800998687744141e+01 | 5.461093750000000000e+02
3.645971369743347168e+01 | 5.463742675781250000e+02
3.649142456054687500e+01 | 5.461682128906250000e+02
3.652459168434143066e+01 | 5.461794433593750000e+02
3.656430697441101074e+01 | 5.465158691406250000e+02
3.659644460678100586e+01 | 5.462177734375000000e+02
3.661709570884704590e+01 | 5.459980468750000000e+02
3.666470932960510254e+01 | 5.462158203125000000e+02
3.669656825065612793e+01 | 5.463444824218750000e+02
3.673000597953796387e+01 | 5.465065917968750000e+02
3.675985097885131836e+01 | 5.460961914062500000e+02
3.679178237915039062e+01 | 5.458977050781250000e+02
3.683040165901184082e+01 | 5.461223144531250000e+02
3.686221385002136230e+01 | 5.463298339843750000e+02
3.689643383026123047e+01 | 5.460991210937500000e+02
3.693139076232910156e+01 | 5.462187500000000000e+02
3.696314668655395508e+01 | 5.463278808593750000e+02
3.699603438377380371e+01 | 5.463562011718750000e+02
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
