Image-X-Institute/IntERAct/RealSense verification/Testing_1DoF_ImageX_March_2026/time_array20260224_153903_analysis_flats.csv

flat_idx | t_start_s | t_end_s | duration_s | level_mean_mm | level_median_mm | level_std_mm
1 | 0 | 8.38403797149658 | 8.38403797149658 | -0.0084867931547619 | 0.001220703125 | 0.0399310918451139
2 | 14.2377586364746 | 14.7145795822144 | 0.476820945739746 | -50.247900390625 | -50.483642578125 | 0.704004203062005
3 | 15.2071399688721 | 15.7787415981293 | 0.571601629257202 | -50.5018853081597 | -50.668212890625 | 0.488184006326277
4 | 16.9850780963898 | 21.8915894031525 | 4.9065113067627 | 0.0882271431587838 | 0.0791015625 | 0.0451761042562371
