Image-X-Institute/IntERAct/RealSense verification/Testing_1DoF_ImageX_March_2026/time_array20260224_153903_analysis_ramps.csv

between | direction | dur_flat_to_flat_s
Flat 1 -> Flat 2 | down | 5.85372066497803
Flat 2 -> Flat 3 | down | 0.492560386657715
Flat 3 -> Flat 4 | up | 1.2063364982605
