Image-X-Institute/IntERAct/RealSense verification/Testing_1DoF_ImageX_March_2026/time_array20260224_154032_analysis_ramps.csv

between | direction | dur_flat_to_flat_s
Flat 1 -> Flat 2 | down | 1.38232898712158
Flat 2 -> Flat 3 | down | 0.8649742603302
Flat 3 -> Flat 4 | down | 0.299973726272583
Flat 4 -> Flat 5 | down | 1.10013961791992
Flat 5 -> Flat 6 | up | 0.297111034393311
Flat 6 -> Flat 7 | down | 0.958745002746582
Flat 7 -> Flat 8 | up | 1.232577085495
Flat 8 -> Flat 9 | down | 1.19541883468628
Flat 9 -> Flat 10 | down | 0.605302333831787
Flat 10 -> Flat 11 | down | 0.297967433929443
