Image-X-Institute/IntERAct/Traces/LARK & SABR TRACES/13.02.24 LARK & SABR/LARK_traces/Unused traces/10.rAP_test_trace_resp.txt

0,0
0.2,-0.0168
0.4,-0.0337
0.6,-0.0505
0.8,-0.0673
1,-0.0842
1.2,-0.1
1.4,-0.1158
1.6,-0.1316
1.8,-0.1474
2,-0.1632
2.2,-0.1775
2.4,-0.1917
2.6,-0.206
2.8,-0.2203
3,-0.2345
3.2,-0.2469
3.4,-0.2592
3.6,-0.2715
3.8,-0.2838
4,-0.2962
4.2,-0.3062
4.4,-0.3162
4.6,-0.3262
4.8,-0.3361
5,-0.3461
5.2,-0.3536
5.4,-0.3609
5.6,-0.3683
5.8,-0.3756
6,-0.3829
6.2,-0.3876
6.4,-0.3921
6.6,-0.3965
6.8,-0.401
7,-0.4055
7.2,-0.4072
7.4,-0.4086
7.6,-0.4101
7.8,-0.4116
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
