Image-X-Institute/IntERAct/Traces/LARK & SABR TRACES/13.02.24 LARK & SABR/LARK_traces/Unused traces/8.rLR_test_trace.txt

0,0,0,0,14.6667,0,0
0.2,0,0,0,14.6606,0,0
0.4,0,0,0,14.6545,0,0
0.6,0,0,0,14.6484,0,0
0.8,0,0,0,14.6423,0,0
1,0,0,0,14.6362,0,0
1.2,0,0,0,14.6183,0,0
1.4,0,0,0,14.6002,0,0
1.6,0,0,0,14.5821,0,0
1.8,0,0,0,14.564,0,0
2,0,0,0,14.5459,0,0
2.2,0,0,0,14.5166,0,0
2.4,0,0,0,14.4871,0,0
2.6,0,0,0,14.4576,0,0
2.8,0,0,0,14.4281,0,0
3,0,0,0,14.3986,0,0
3.2,0,0,0,14.3588,0,0
3.4,0,0,0,14.3187,0,0
3.6,0,0,0,14.2787,0,0
3.8,0,0,0,14.2386,0,0
4,0,0,0,14.1986,0,0
4.2,0,0,0,14.1496,0,0
4.4,0,0,0,14.1002,0,0
4.6,0,0,0,14.0508,0,0
4.8,0,0,0,14.0014,0,0
5,0,0,0,13.952,0,0
5.2,0,0,0,13.8952,0,0
5.4,0,0,0,13.838,0,0
5.6,0,0,0,13.7809,0,0
5.8,0,0,0,13.7237,0,0
6,0,0,0,13.6665,0,0
6.2,0,0,0,13.6036,0,0
6.4,0,0,0,13.5403,0,0
6.6,0,0,0,13.4771,0,0
6.8,0,0,0,13.4138,0,0
7,0,0,0,13.3505,0,0
7.2,0,0,0,13.2834,0,0
7.4,0,0,0,13.216,0,0
7.6,0,0,0,13.1486,0,0
7.8,0,0,0,13.0812,0,0
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
