Image-X-Institute/IntERAct/(threads)

Thread 4 (2022-04-18):

The origin of motion - z coordinate flipped

ChandrimaSengupta, 2022-04-18:
The origin of motion (z coordinate) needs to be reversed, i.e., when the rotation centroid is calculated w.r.t. the default origin of motion of the TCP, the z coordinate needs to be flipped (as opposed to IEC convention). Please see the updated documentation 'Getting Started' guide. This issue will be fixed in the next release. For the time being, follow the updated documentation.

This won't affect any translational motion, however, will affect rotation around z axis.

Thread 5 (2023-01-15):

Actual vs expected motion

medphysJH, 2023-01-15:
I encountered an issue where there was a delay between the expected and actual trace as displayed on the screen.
It didn't occur every run but when it occurred it was noticeable and appeared to be real.
The image below shows this (dotted line = expected, solid line = actual).
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

medphysJH, 2023-01-23:
Possibly related to this was an issue where the plot of actual translation and plot of actual rotation were not aligned in time.
For example the translation plot showed 500 seconds gone whereas the rotation plot only showed 450 seconds.

Thread 10 (2023-01-23):

Report on accuracy of motion

medphysJH, 2023-01-23:
Can the application report on how accurately it achieved the current trace?
Using the expected and the actual could it give an RMS error, along with maximum and minimum error or distribution of errors?

Thread 14 (2023-01-23):

UI registering button clicks

medphysJH, 2023-01-23:
It was sometimes hard to tell whether the UI had registered a button click.
It would be useful for button presses to be highly noticeable or indicated by a change in the UI.
For example clicking home could update the Current position to be all zeros (assuming the robot is actually in the home position).

medphysJH, 2023-01-23:
Connected to this, could the current position of the robot be consistently updated anytime that the application is connected to the robot.

Thread 16 (2024-01-24):

Uncertainty estimate included in motion output file measurements

akac0297, 2024-01-24:
Feature request:

It would be useful if the output motion file from the robot + 1D platform (calculated from the voltages) had an associated uncertainty measurement - this could be calculated from experiments using the platform with various traces (which may need to be repeated a couple of times to see how reproducible the motion is).

Thread 17 (2024-01-24):

(1D Platform Integration) - Program crashes when incompatible motion trace file is loaded to the 1D robot.

AbbasZahr, 2024-01-24:
Rather than it crashing, it should present an error and prompt the user to load a compatible file.

AbbasZahr, 2024-02-06:
Issue Fixed, Message Box pops up now advising user of incorrect format, allows user to reselect file instead of crashing.

Thread 18 (2024-01-24):

(1D Platform Integration) - Program crashes when Arduino USB is unplugged while the trace is being played. (WIP)

AbbasZahr, 2024-01-24:
This should present an error rather than crash the program.

AbbasZahr, 2024-02-06:
Issue Fixed. Program now displays message box advising the user that the Arduino/1D robot was disconnected, instructing the user to restart the program and reconnect the robot.

Thread 19 (2024-01-24):

(1D Platform Integration) - Home needs to be pressed 2 or 3 times quickly for the Arduino to process the 'Home' command (WIP)

AbbasZahr, 2024-01-24:
Need to implement a fix that requires the 'Home' button to be pressed once for the Arduino to go to home position.

AbbasZahr, 2024-02-06:
Issue fixed, Pressing "Home" successfully homes the actuator, very responsive and works every time.

Closed 2024-02-06.

Thread 20 (2024-01-24):

(1D Platform Integration) - 1D Platform currently does not stop playing the trace file when 'Stop Motion' is pressed (WIP)

AbbasZahr, 2024-01-24:

akac0297, 2025-05-15:
Working in most recent commit in [IntERAct_dev](https://github.com/Image-X-Institute/IntERAct/tree/IntERAct_dev) branch: 2eec8674d2da36b12fe6d367df4a33506bf2a854.

Closed 2025-05-15.

Thread 22 (2024-01-24):

(1D Platform Integration) - Translation plot improvements (WIP)

AbbasZahr, 2024-01-24:
Due to general feedback, the following improvements to the Realtime plots would be ideal to achieve:

1. Reduce the x-axis scaling for the plot in order to make the plot less busy, allowing for space to add a new plot in the same chart. Currently, the x-axis (time) has the range from 0 seconds to the max length of the trace.
2. Implement the translation plots of the 1D robot on the same graph as the 6DOF robot.
3. While reducing the x-axis scaling for the translational plot, implement auto scrolling so that the whole trace file is able to be viewed from beginning to end. the scale for the x axis should have a range of 10-20 seconds max.
4. Allow to toggle between the 6DOF trace, 1D trace or both traces

AbbasZahr, 2024-02-26:
UPDATE

1. Reduce the x-axis scaling for the plot in order to make the plot less busy, allowing for space to add a new plot in the same chart. Currently, the x-axis (time) has the range from 0 seconds to the max length of the trace. (COMPLETED: Implemented range adjustment, zooming and panning)

Before:
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

After:
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
As you can see on the right, there is a range slider which will adjust how far from the start the user wants to view the trace. This is most useful when playing the motion trace and viewing the real time output plots. Additional: Also added Reset Zoom button. Since zooming and panning is also implemented (with click and drag, scroll wheel etc), the user may want to reset the plot zoom.

2. While reducing the x-axis scaling for the translational plot, implement auto scrolling so that the whole trace file is able to be viewed from beginning to end. the scale for the x axis should have a range of 10-20 seconds max. (COMPLETED: When playing a trace, the range can be adjusted from 0 to the max time possible from the trace; it will now follow the Realtime data being plotted too. Range can be adjusted by the slider on the right hand side

3. Implement the translation plots of the 1D robot on the same graph as the 6DOF robot. (COMPLETED: Implemented 1D robot input plots and real-time feedback/output plots on the same translation chart)

4. Allow to toggle between the 6DOF trace, 1D trace or both traces. (COMPLETED: Implemented buttons to toggle between 6DOF, 1D or Both traces)

Both:
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

Toggle 6DOF:
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

Toggle 1D:
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

Additional Notes:
1. Improved and cleaned up UI. Buttons colours and positioning
2. Improved how the UI buttons, controls and plots scale according to screen size. This works fine with any resolution however if the user's display scaling is not set at 100%, there could be scaling issues. To check, go into Display Settings on your device (currently implemented for Motion Control tab only, not the Log or Settings tab).
3. (WIP) Plotting the 1D optical feedback onto the translation chart,

Thread 23 (2024-01-30):

Changing trace

medphysJH, 2024-01-30:
Allow the user to change the trace without playing it.
For example if the user loads the incorrect trace or changes their mind and doesn't want to click play before loading the new trace.

Thread 26 (2024-01-30):

UI elements off screen

medphysJH, 2024-01-30:
If the application isn't in full screen or is being displayed on a different sized screen not all the UI elements are visible.
Add scroll bars to the display if any elements are not displayed.

AbbasZahr, 2024-02-28:
Added UI resizing. Controls such as buttons and graphs will automatically resize itself according to window size. Currently works fine if Scaling in windows display settings is set to 100% and works for any resolution (e.g. 2560x1440 or 1920x1080 etc.)

Window Minimised:
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

Window Full Screen:
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

Also added scroll bars to settings menu:
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

Still need to fix issues with scaling if the PC's scaling is not set to 100% (sometimes people will be using 125% scaling which causes the graphs to not resize properly however all buttons should be accessible).

Thread 29 (2024-01-30):

Sample frequency

medphysJH, 2024-01-30:
Either set the sample frequency automatically according to the loaded file.
And/or
Resample all loaded files to 5 Hz

Investigate why 10 Hz files don't load and run efficiently.

ChandrimaSengupta, 2024-06-03:
Read the frequency from the input file but show a message if the frequency is < 0.2 s.

Thread 33 (2024-01-30):

Robot home position

medphysJH, 2024-01-30:
Record the home position in the log in both application and robot co-ordinate systems.

Allow the user to load a home position (not just set it).
This would be useful in case the application crashes when the robot isn't in the home position.

Thread 35 (2024-03-26):

Robot crashing when reproducing a specific trace

medphysJH, 2024-03-26:
When I loaded the attached trace to the application and pressed 'play' approximately 170-180 seconds into the trace the robot jumped in all directions (by 3-8 mm) then reported an error and crashed.

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
[Prostate_continuous drift_10Hz.txt](https://github.com/Image-X-Institute/6-DoF-Robotic-Motion-Phantom/files/14751273/Prostate_continuous.drift_10Hz.txt)

Thread 44 (2024-06-26):

Ur Scripts files take some time to be written (Combined system 1DoF +6DoF platforms)

ChrisKuban, 2024-06-26:
Before to run a 6D trace, the function "SaveUrScripts" is called to write the data that will be send to the robot controller in a .txt file. This procedure can take a little bit of time (tested on two intel Core i7).

Before to click on "Play Motion", make sure that the .txt file is fully generated. If the user clicks on "Play Motion" during the generation of the file, the following error will appear :

[Collection was modified; enumeration operation may not execute]

akac0297, 2024-11-28:
Note: This is an ongoing issue. If the 6DoF UrScript file is not completely generated before clicking 'play motion' (for either the combined system or 6DoF platform alone), the 1DoF platform won't work and only the 6DoF platform will move and may crash. The robot may also continue to move with the PhantomControl software crashing, requiring the use of the emergency stop button on the robot controller tablet.

akac0297, 2025-05-29:
Solved with recent commit 96a4b224bc9b8d29d182085961125f448818d012 in [IntERAct_dev](https://github.com/Image-X-Institute/IntERAct/tree/IntERAct_dev) branch.

Closed 2025-05-29.

Thread 45 (2024-06-26):

6DoF robot runs incorrectly when subsequent points in time have the same position value

akac0297, 2024-06-26:
The 6DoF robot does not operate properly when subsequent points in time have the same position value - the robot seems to take these points as a single time point - likely an issue with inverting matrices when the robot tries to figure out what position to move to next (i.e. issue with calculating relative change in position).

Current workaround: process 6DoF motion traces so if subsequent points have the same position, change the second by +0.1 mm. This seems to work fine.

Thread 50 (2024-10-15):

Looking not working - test different versions

ChandrimaSengupta, 2024-10-15:

akac0297, 2024-11-28:
Note: currently no version appears to have the looping working, with the motion platform appearing to glitch out for traces >= 5 minutes long. Functionality is still good for traces shorter than 300 seconds long.

akac0297, 2025-02-04:
Update - most recent commit bc16b34 has resolved this for 6DoF robot only - so when 6DoF robot is used you can now run traces >5 minutes. Note there is an unavoidable time gap between these 5 minute segments as the next packet of information is sent to the robot controller.

Thread 51 (2024-10-15):

Not all Output Files (robot/platform log) folders are automatically generated upon downloading the code

akac0297, 2024-10-15:
Users need to make sure these are present, and manually generate the following folders in this location:
6-DoF-Robotic-Motion-Phantom\Program Files\src\PhantomControl\bin\Release\Output Files

Folders:
1DPlatform
-Arduino
--Get
--Send
-Timestamps
6DPlatform
GeneratedURScripts
Log

* To be fixed in the code in a later version

akac0297, 2025-02-04:
resolved with most recent code update - Commit bc16b34: https://github.com/Image-X-Institute/IntERAct/commit/bc16b34f3f88e044ebf7a1aad1b62058597cb3d5

Closed 2025-02-04.

Thread 53 (2024-11-28):

Unable to zoom out on settings page of motion control software

akac0297, 2024-11-28:
Somewhat minor issue, but while the Motion Control tab and plots are scaled well when the size of the application window is changed, the Settings tab buttons and features are not rescaled/zoomed out when the size of the application window is changed. This could be improved in future iterations of the software to allow for more flexibility of use.

Thread 54 (2025-02-21):

Add timestamp in milliseconds for motion trace

ChenC8, 2025-02-21:
Could we please have the timestamp in millisconds recorded either in the log for the motion trace start or in the output motion trace text files?

akac0297, 2025-04-16:
Feature now added to most recent commit (56cf344d17cdc61c0ee25a6d49179306577928a5).

Closed 2025-04-16.

Thread 55 (2025-03-31):

IntERAct platform connections not working if Bluetooth in use

akac0297, 2025-03-31:
Currently, the IntERAct device doesn't work when Bluetooth on the IntERAct motion control software computer is in use - this is because the code loops through all serial port connections to find the component platforms.
Temporary fix: ensure no devices (e.g. wireless headphones) are connected via Bluetooth when running the motion control software/IntERAct device.

ChandrimaSengupta, 2025-05-14:
I think this is a well known fact when TCP/IP is used and not InteRact specific. I will close this and can you please add this in the instructions?

akac0297, 2025-05-15:
Added instructions to (Readme file)[https://github.com/Image-X-Institute/IntERAct/blob/main/Documentation/6DoF/README.md] in Documentation folder.

Closed 2025-05-15.

Thread 59 (2025-06-10):

Need to wait 10-15 seconds before clicking Home and Load/Play motion to avoid crashing software

akac0297, 2025-06-10:
Appears to be a bug where a log is being written during this time. Could grey out the buttons to prevent clicking on the next button in the sequence (Set start position -> Home -> Load 6DoF and/or 1DoF -> Play motion) when the log is being written, to prevent this error (as there is only a short delay needed, unlike the [previous issue](https://github.com/Image-X-Institute/IntERAct/issues/44) with an up to 1.5 min delay required).

Thread 60 (2025-06-10):

Apparent drift in 1DoF platform motion during operation

akac0297, 2025-06-10:
When using the robot software on 7 Jun (using IntERAct_dev branch - changes now merged to main), the 1DoF platform appeared to drift upwards 2-3 cm during operation (the actual motion trace had only 4-5 mm motion magnitude). Previously this occurred when there was an issue with the cable connections, or due to a bug in the code (now remedied). Could be a different bug in the software causing this. We also noticed [this issue](https://github.com/Image-X-Institute/IntERAct/issues/59) on the same day of operation.

Thread 62 (2025-06-25):

Add option for feedback for 1D platform and/or replace 1D motor with improved

Paul-Keall, 2025-06-25:
