Image-X-Institute/IntERAct/Documentation/1DoF/1D motion platform circuit diagram.pdf

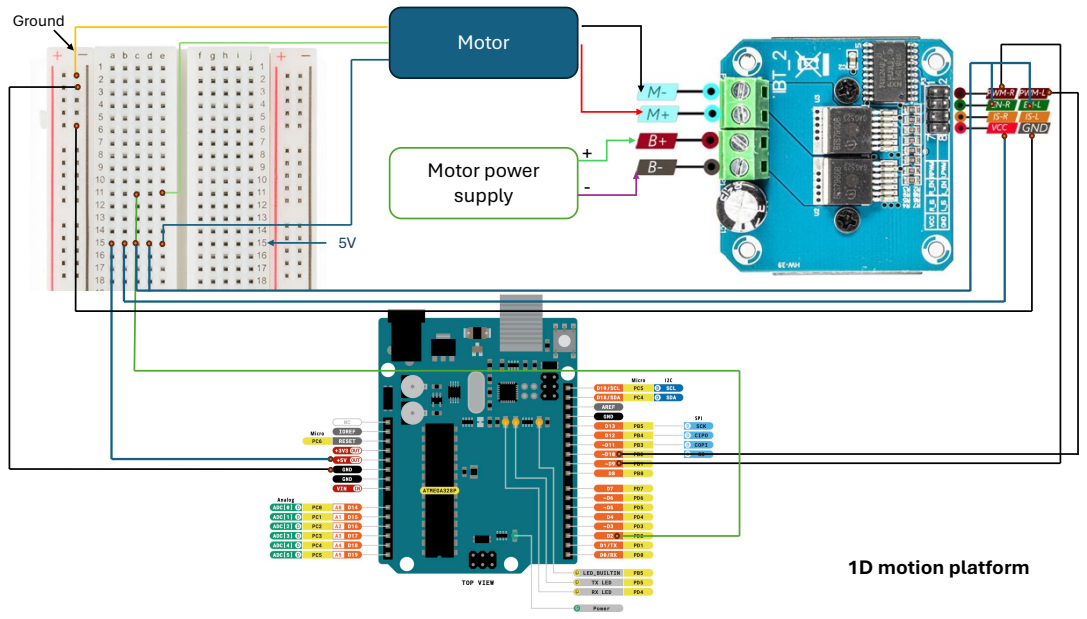
[picture p111: page 1]
Ground; Motor; Motor power supply; 1D motion platform
