Image-X-Institute/IntERAct/Documentation/CAD Drawing of the phantom/Tool Flange Holder.pdf

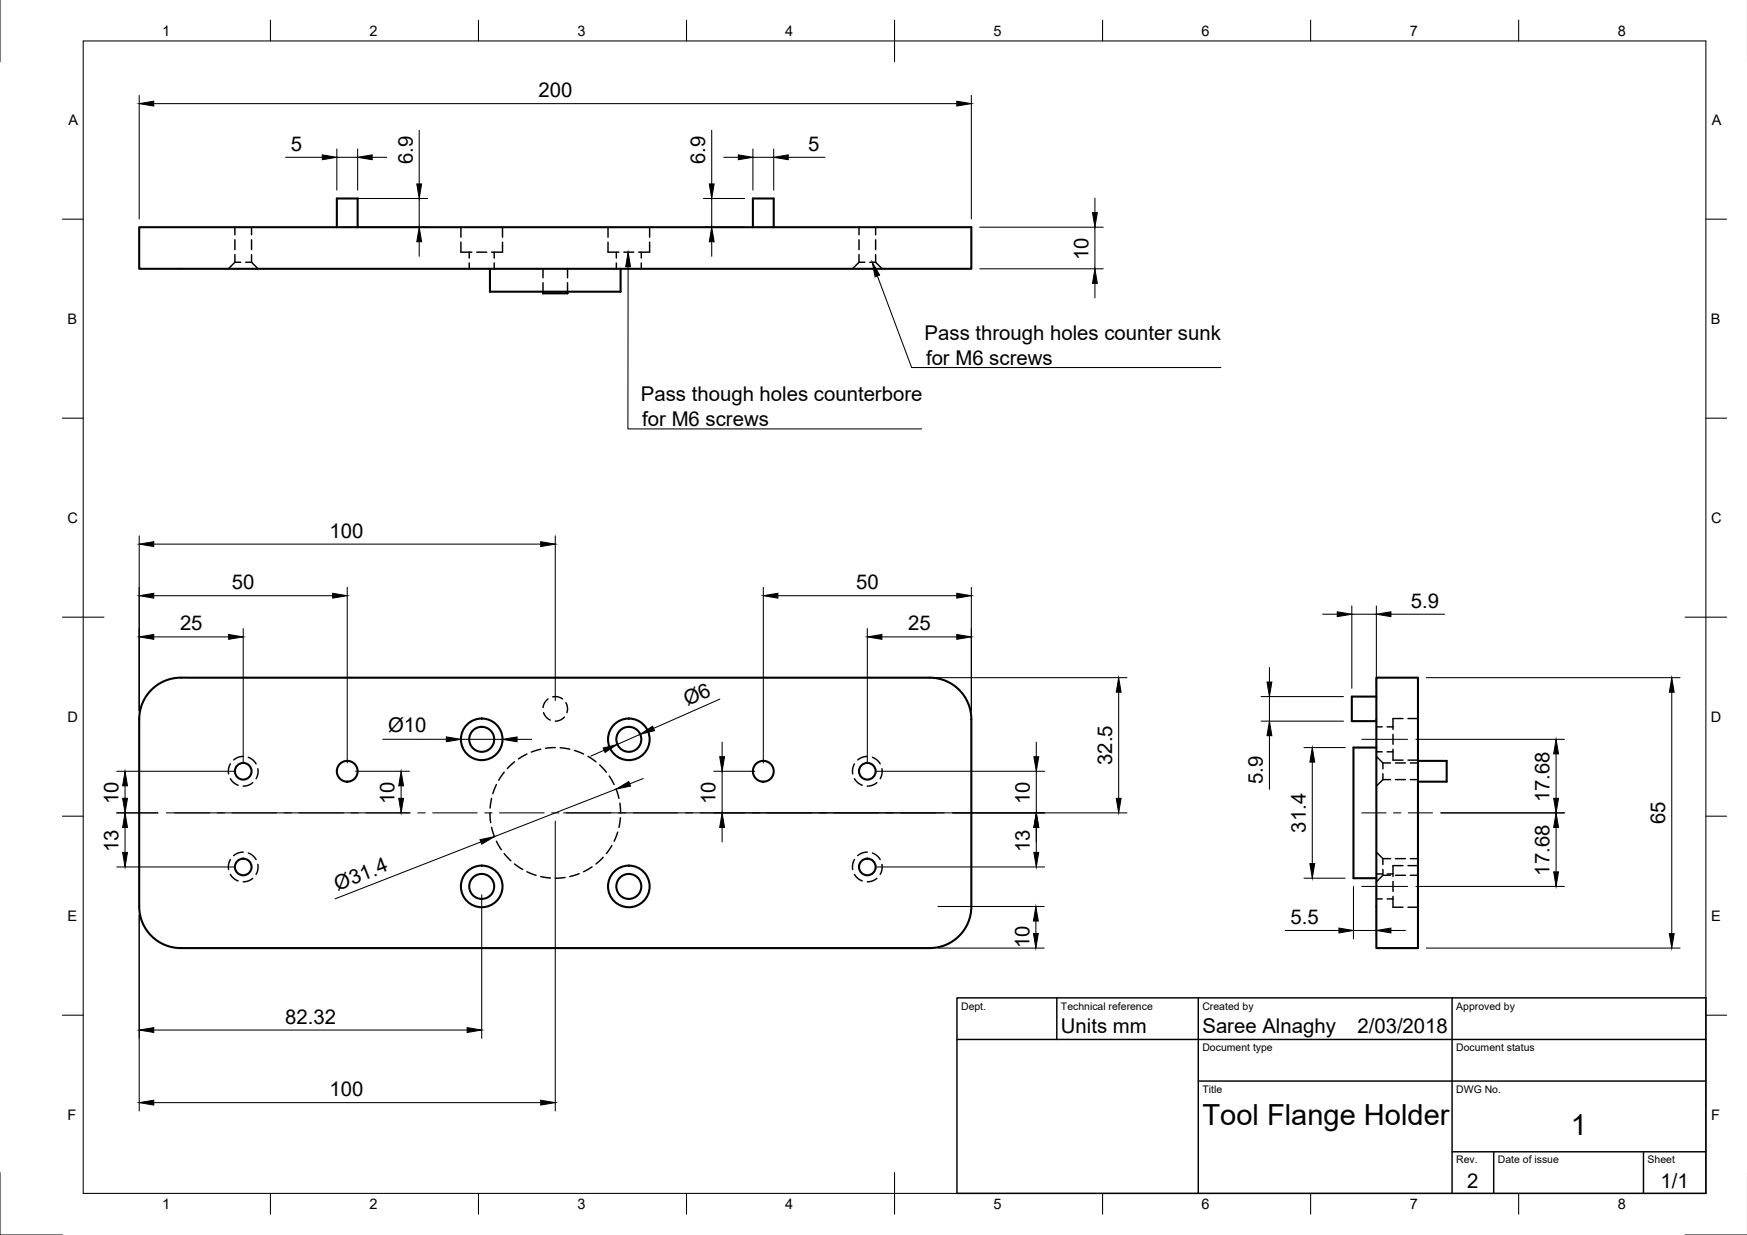
[picture p112: page 1]

Pass through holes counter sunk
for M6 screws

Pass though holes counterbore

Dept. | Technical reference Units mm | Created by Saree Alnaghy 2/03/2018 | Approved by

Document type | Document status

Title | DWG No. 1 Tool Flange Holder

Rev. 2 | Date of issue | Sheet 1/1
