Image-X-Institute/IntERAct/Documentation/CAD Drawing of the phantom/UR16 2D array phantom/PhantomFrame.PDF

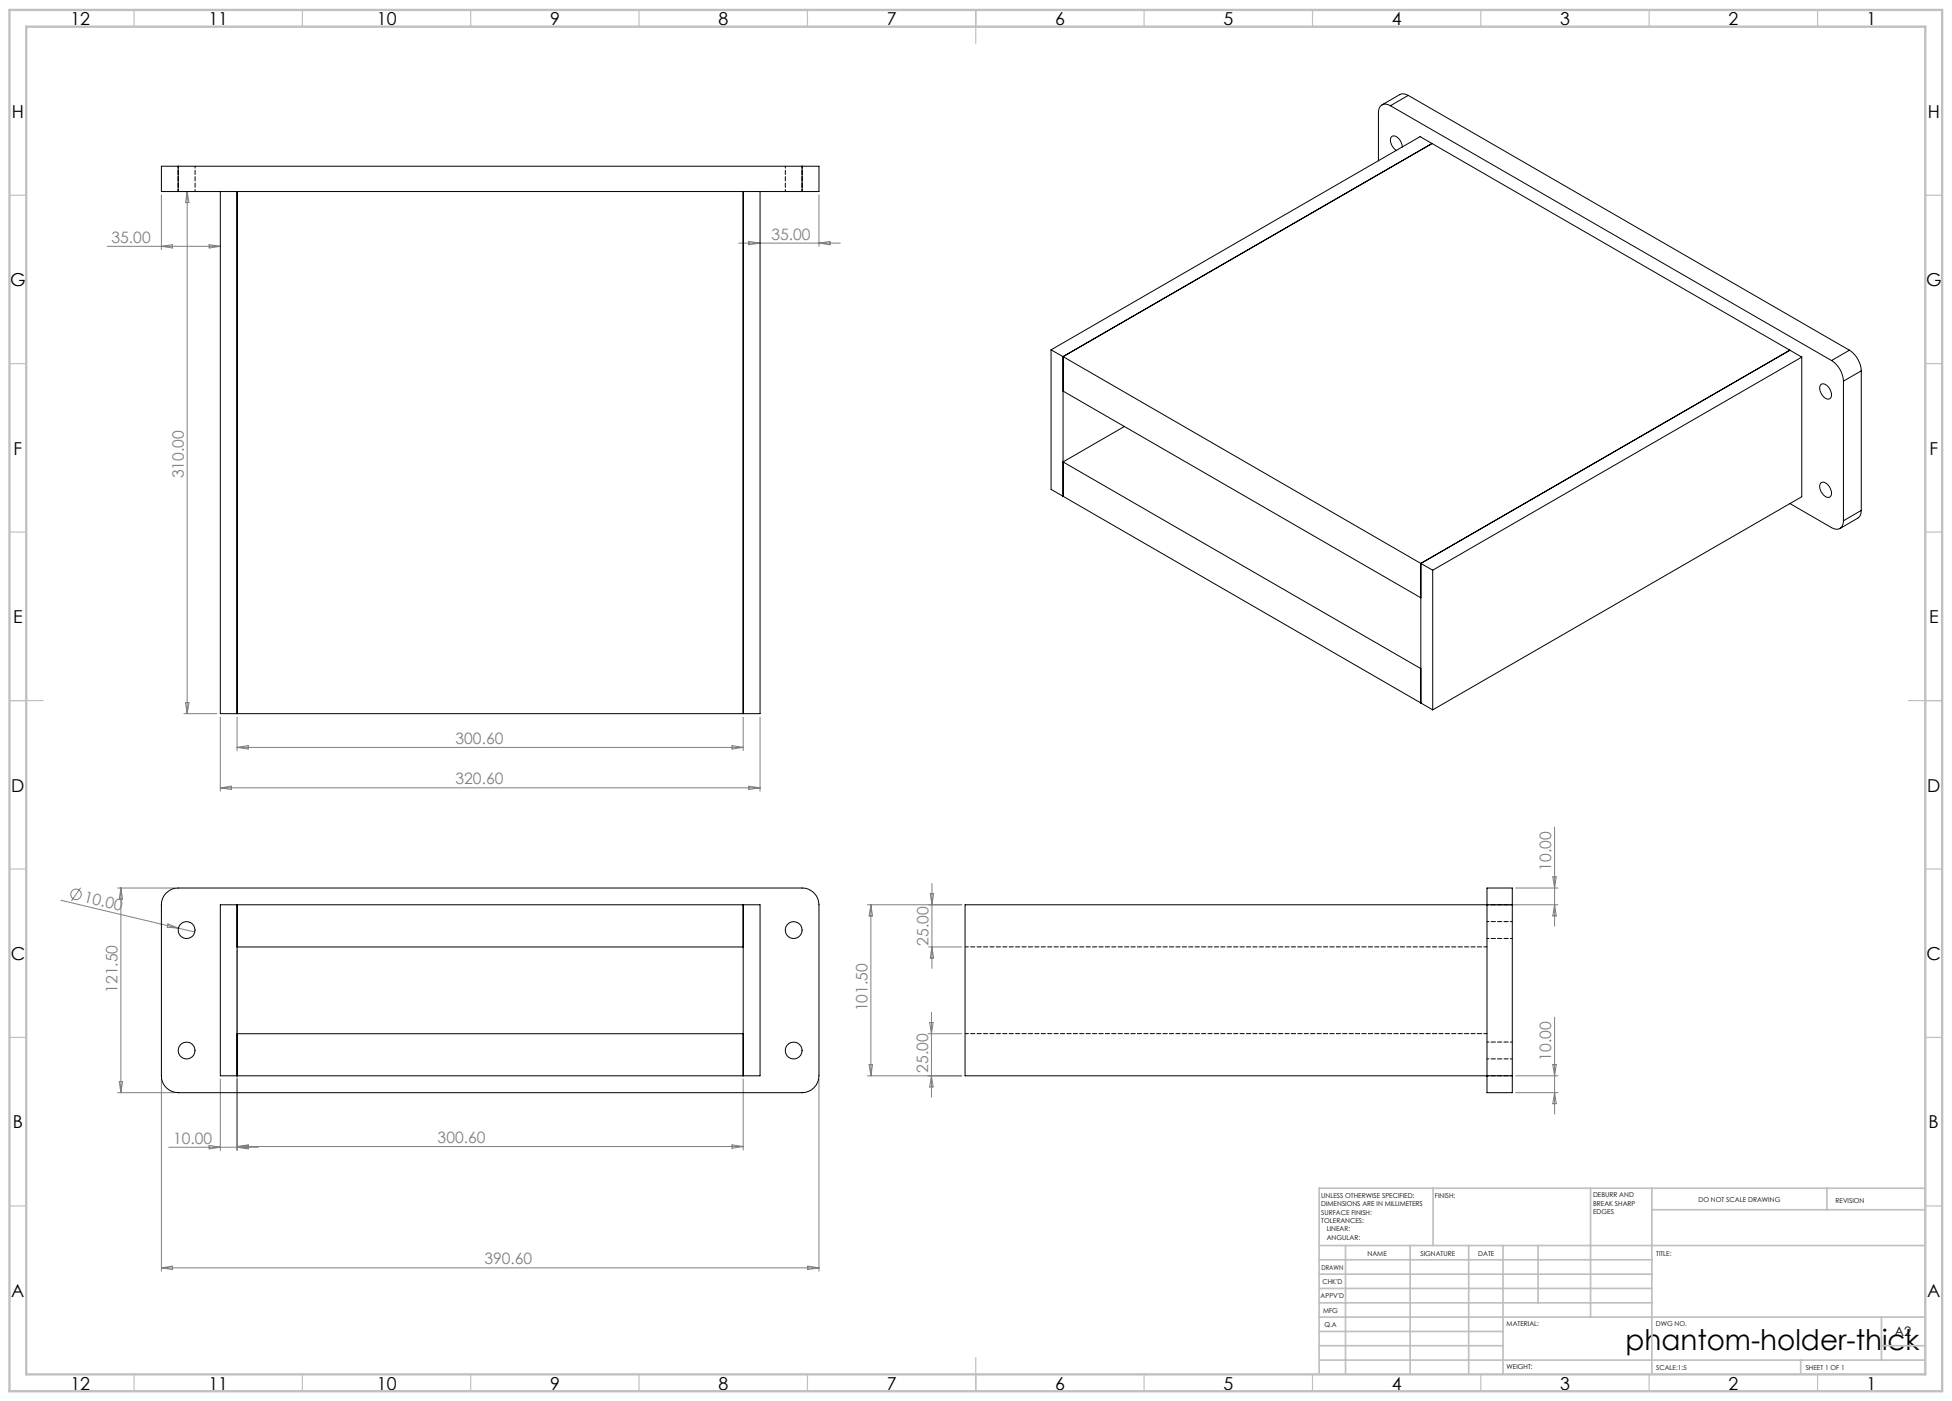
[picture p115: page 1]
SCALE:1:5; SHEET 1 OF 1

UNLESS OTHERWISE SPECIFIED: DIMENSIONS ARE IN MILLIMETERS SURFACE FINISH: TOLERANCES: LINEAR: ANGULAR: | FINISH: | DEBURR AND BREAK SHARP EDGES | DO NOT SCALE DRAWING | REVISION

NAME | SIGNATURE | DATE | | | | TITLE:

DRAWN
CHK'D
APPV'D
MFG
Q.A | | | | MATERIAL: phantom-holder-thick | DWG NO. | A2
