Image-X-Institute/IntERAct/Documentation/CAD Drawing of the phantom/Markerless Phantom with Detector/Phantom B_Plastic Holder.pdf

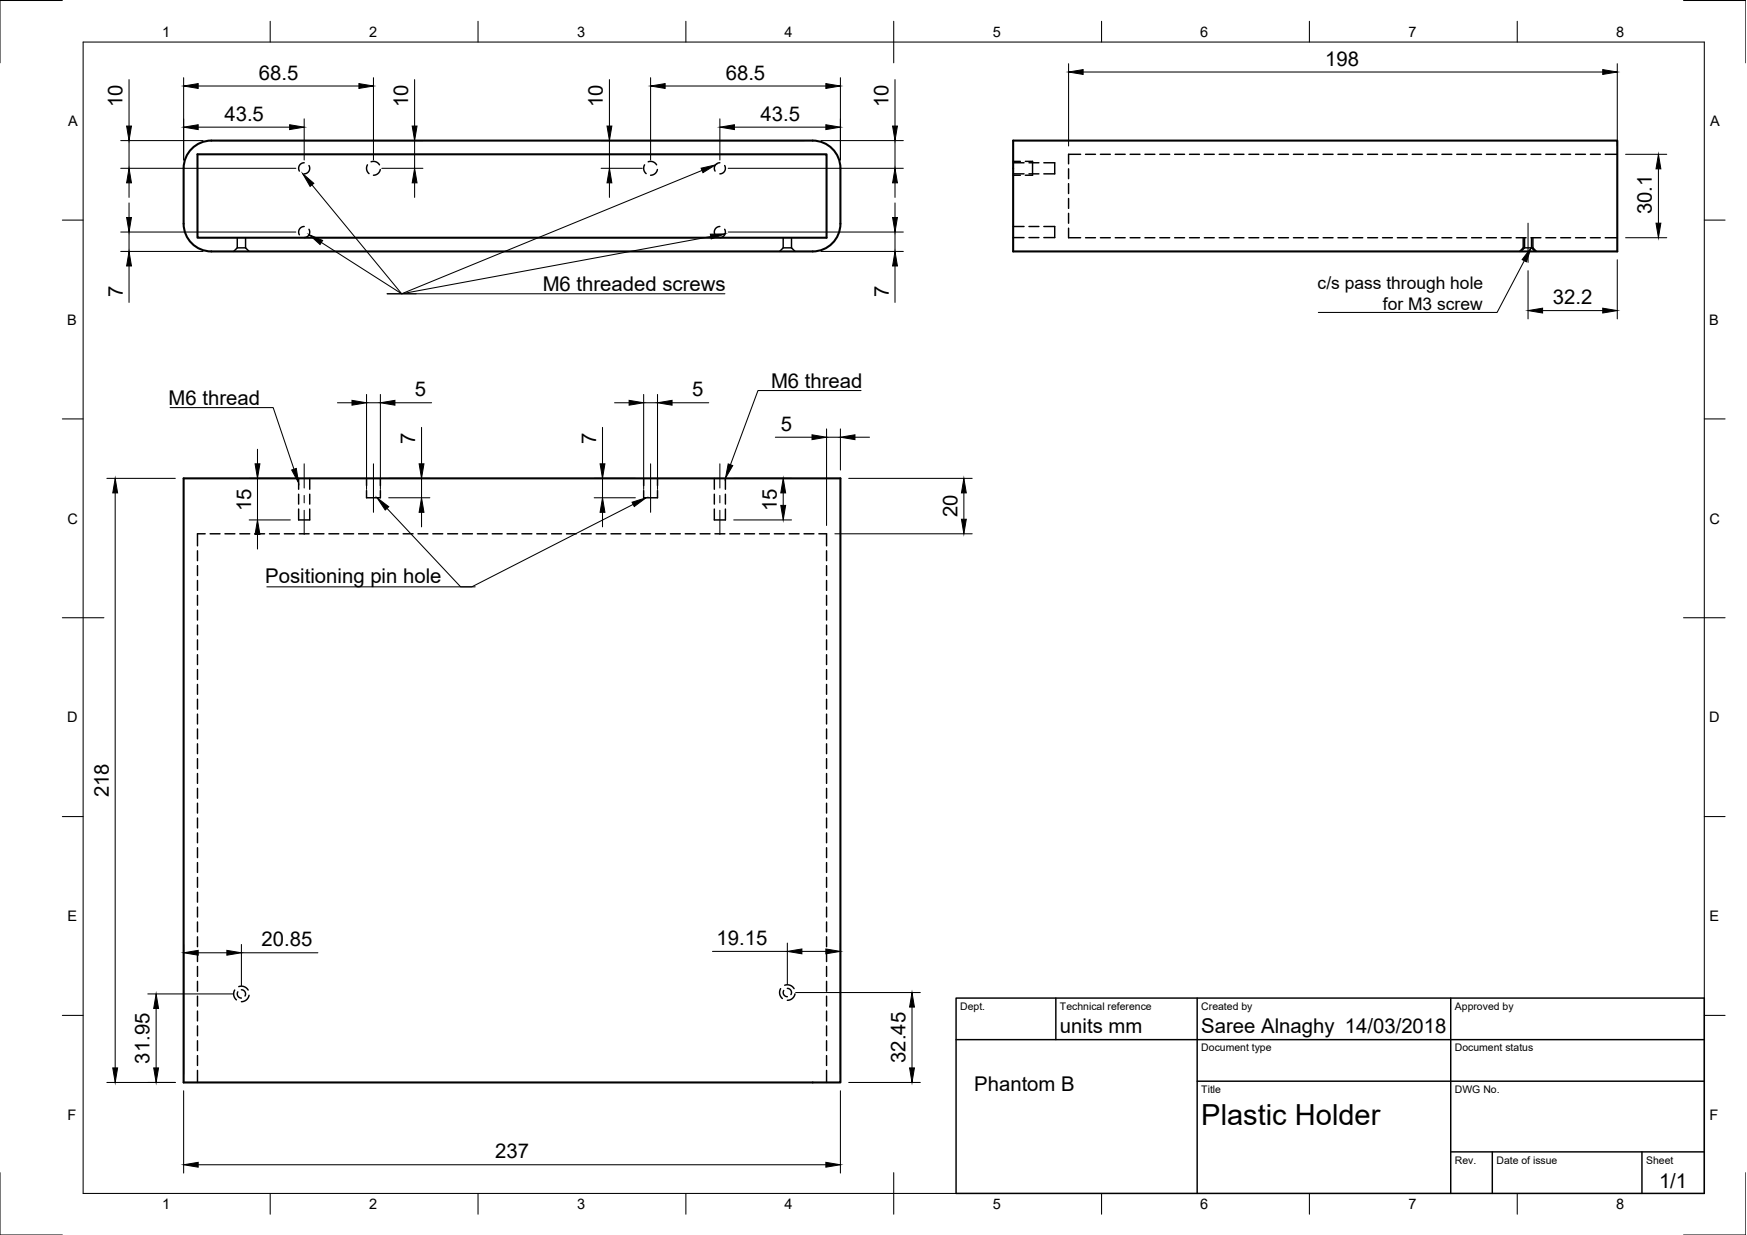
[picture p116: page 1]
M6 threaded screws; for M3 screw 32.45; M6 thread

c/s pass through hole

Positioning pin hole

Dept. | Technical reference units mm | Created by Saree Alnaghy 14/03/2018 | Approved by

Phantom B | | Document type | Document status

Title Plastic Holder | DWG No.

Rev. | Date of issue | Sheet 1/1
