Image-X-Institute/IntERAct/Documentation/CAD Drawing of the phantom/Markerless Phantom with Detector/Phantom B_Wood Insert.pdf

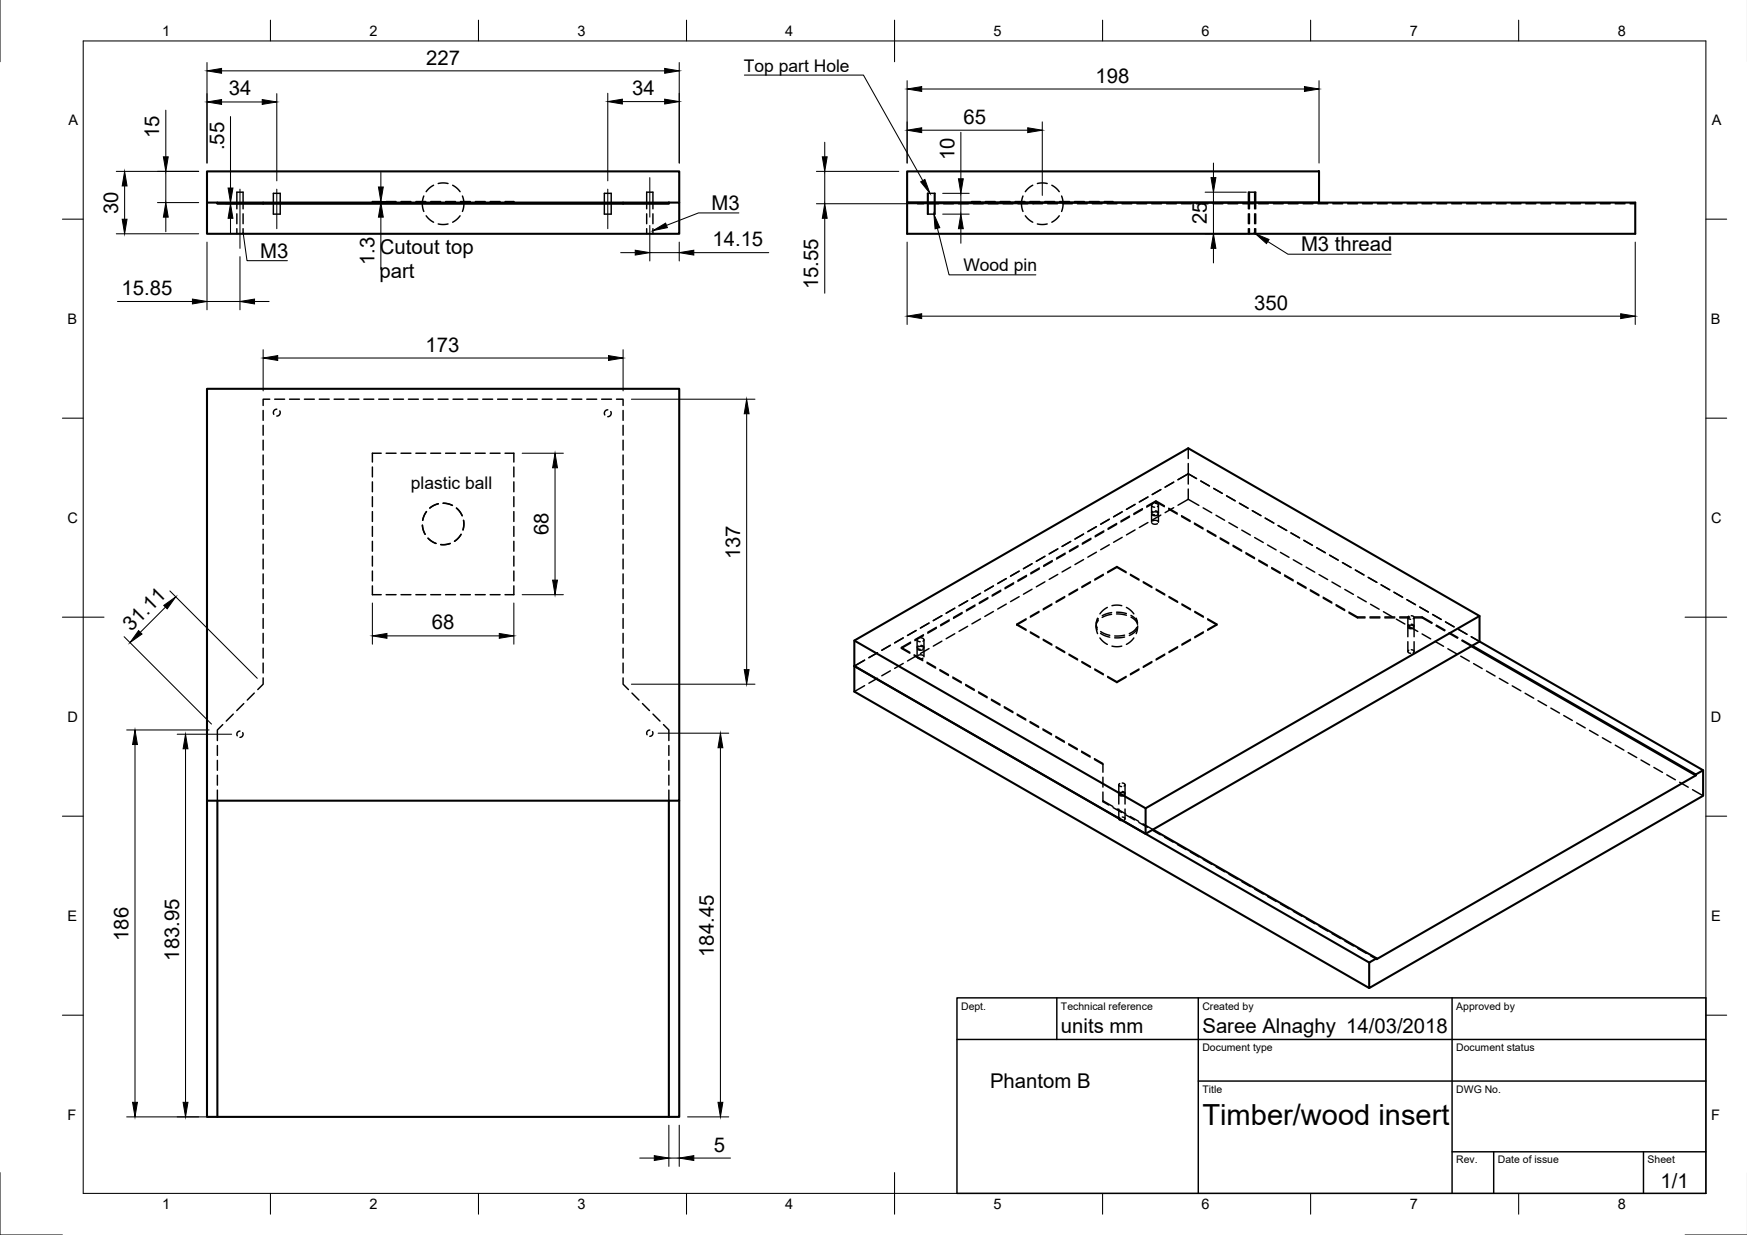
[picture p117: page 1]
M3 thread 25 10; Wood pin; Top part Hole .55; plastic ball; Cutout top

Dept. | Technical reference units mm | Created by Saree Alnaghy 14/03/2018 | Approved by

Phantom B | | Document type | Document status

Title Timber/wood insert | DWG No.

Rev. | Date of issue | Sheet 1/1
