Image-X-Institute/IntERAct/Documentation/CAD Drawing of the phantom/Markerless Phantom/Phantom A_Plastic Holder.pdf

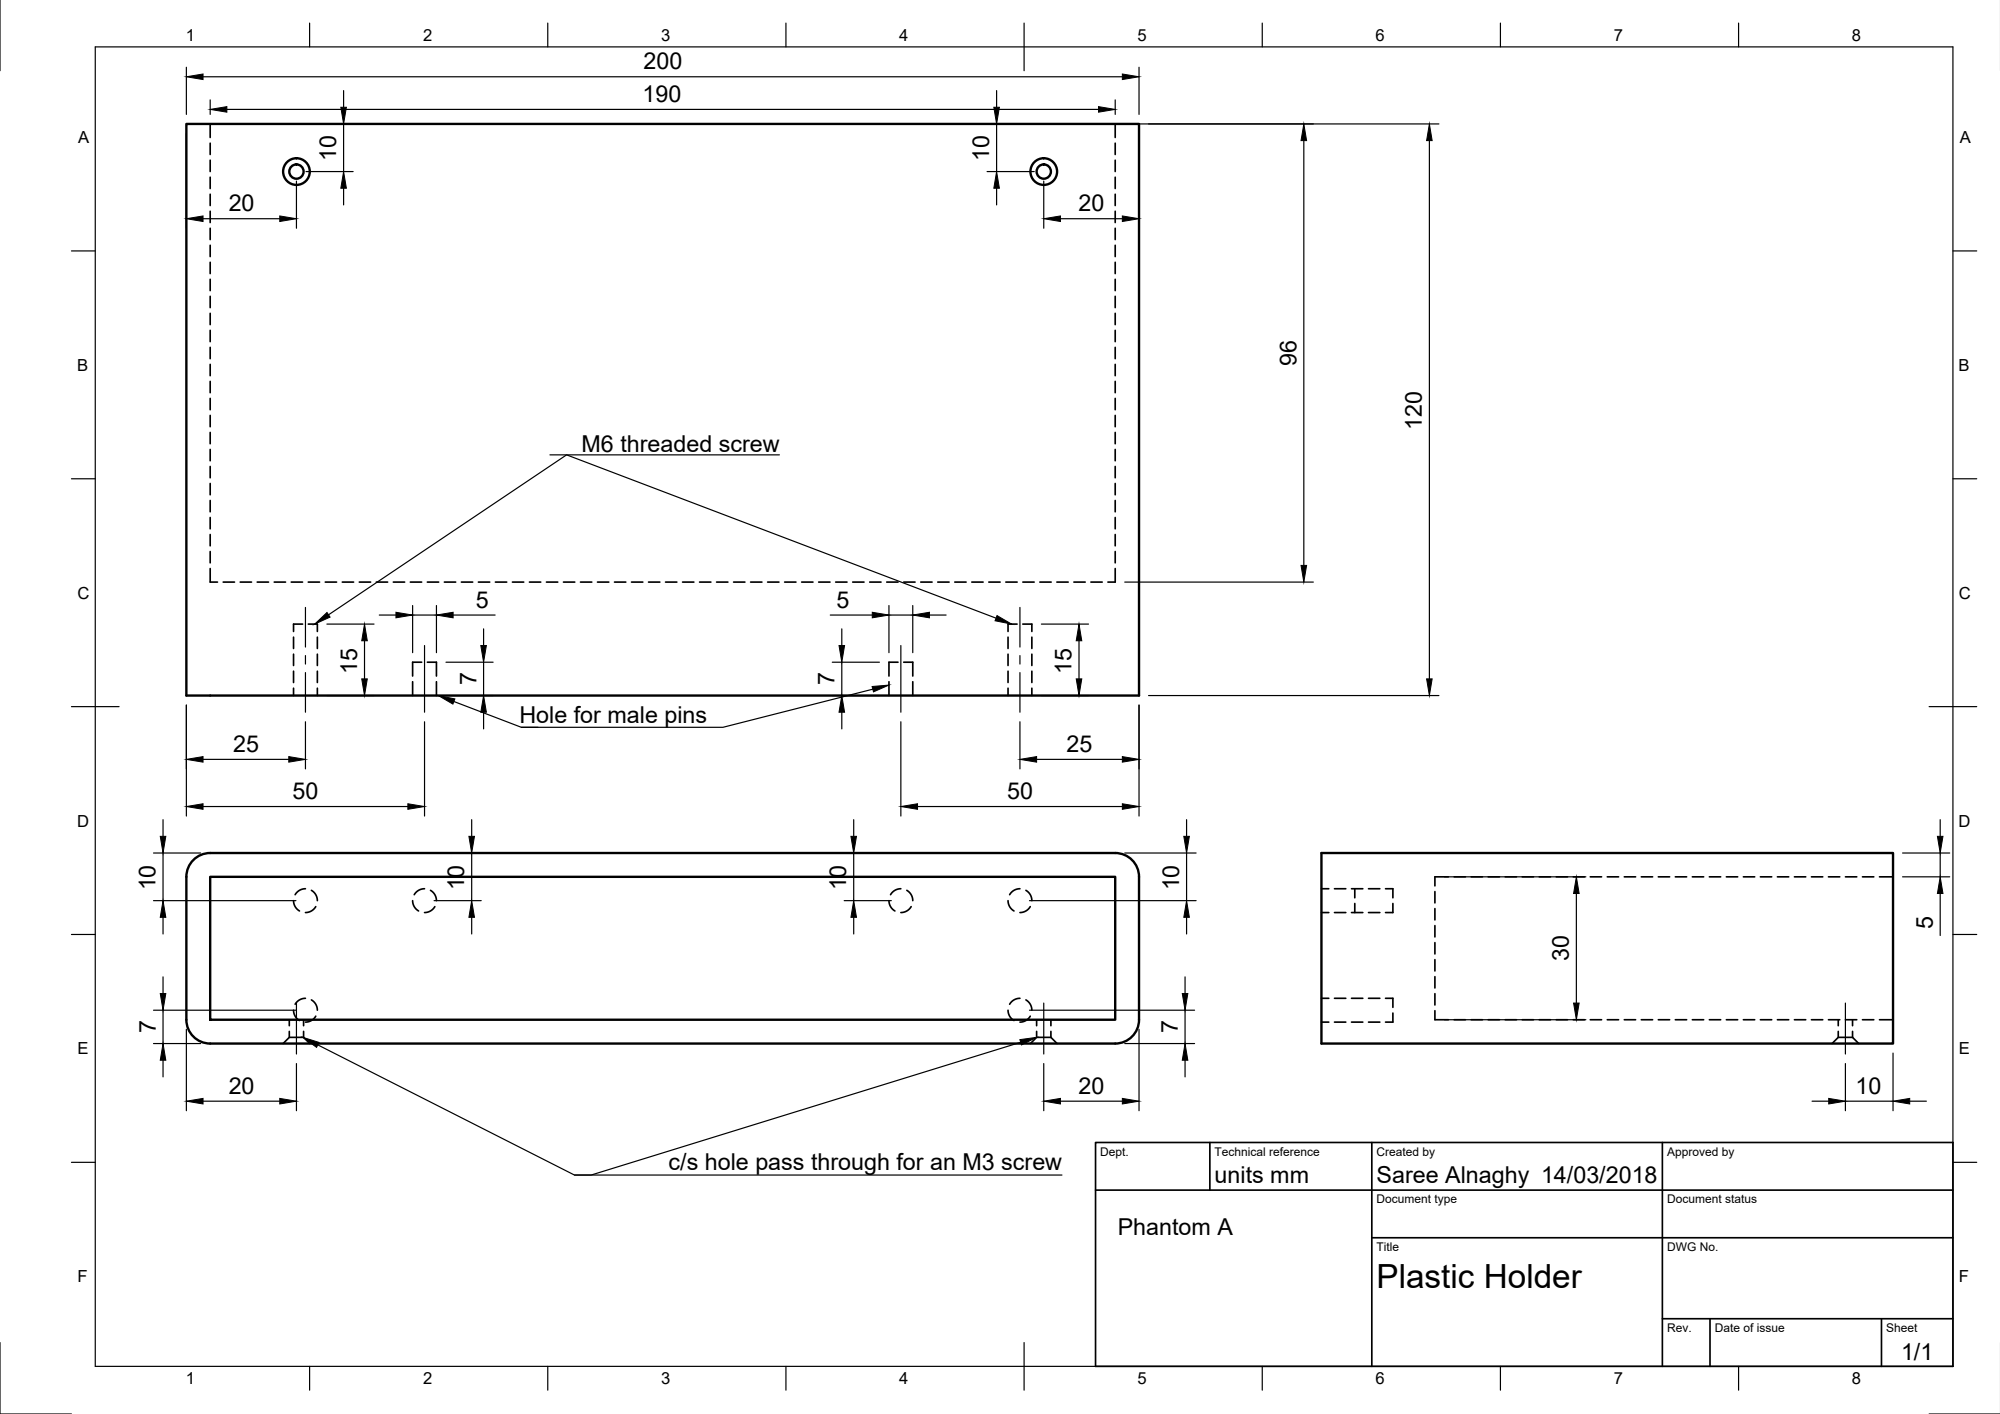
[picture p118: page 1]
units mm; Saree Alnaghy 120 96; M6 threaded screw

Hole for male pins

Dept. | Technical reference | Created by 14/03/2018 | Approved by

c/s hole pass through for an M3 screw

Phantom A | | Document type | Document status

Title Plastic Holder | DWG No.

Rev. | Date of issue | Sheet 1/1
