Image-X-Institute/IntERAct/Documentation/CAD Drawing of the phantom/Markerless Phantom/Phantom A_Wood Insert.pdf

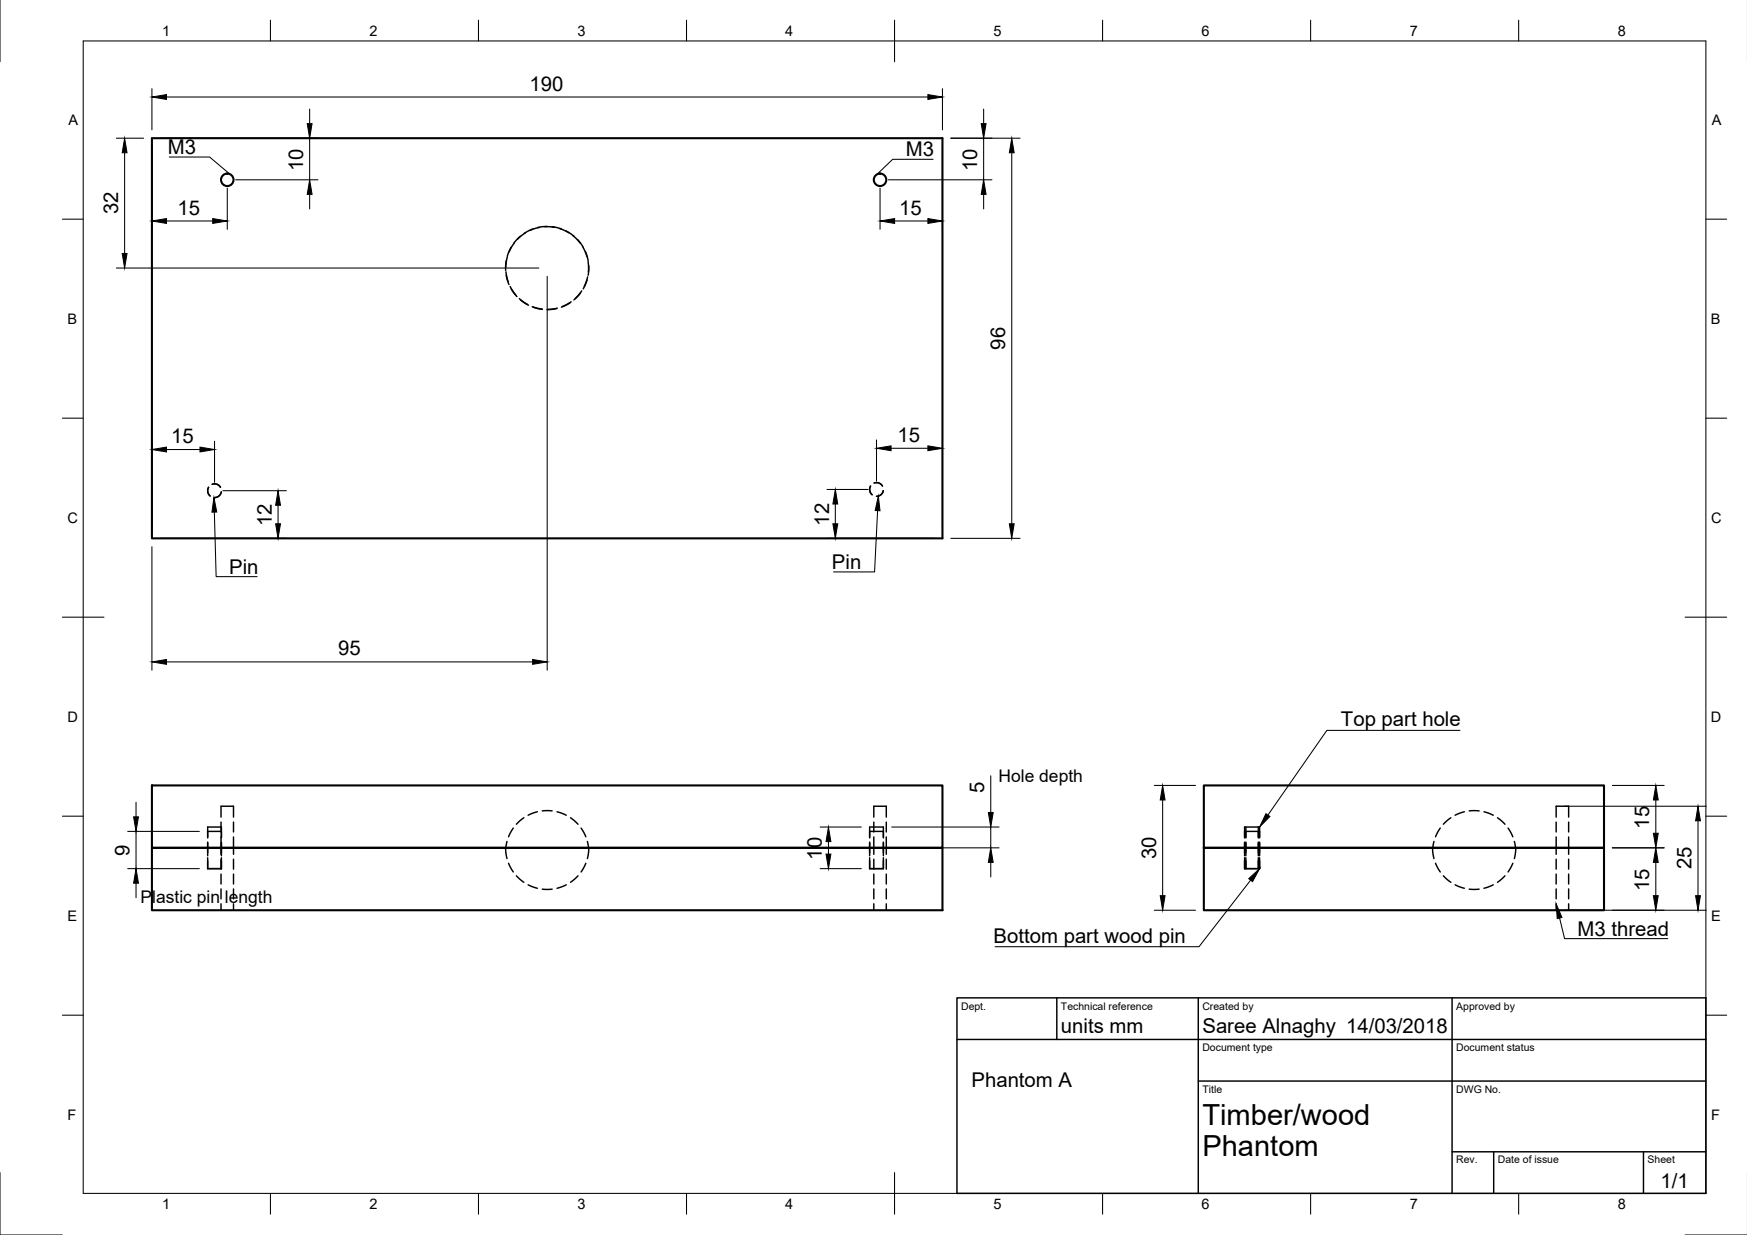
[picture p119: page 1]
M3 thread; 5Hole depth 1030

Top part hole

Plastic pin length

Bottom part wood pin

Dept. | Technical reference units mm | Created by Saree Alnaghy 14/03/2018 | Approved by

Phantom A | | Document type | Document status

Title Timber/wood Phantom | DWG No.

Rev. | Date of issue | Sheet 1/1
