Image-X-Institute/IntERAct/Documentation/CAD Drawing of the phantom/Marker Phantom with Detector/Phantom + Detector Drawing.pdf

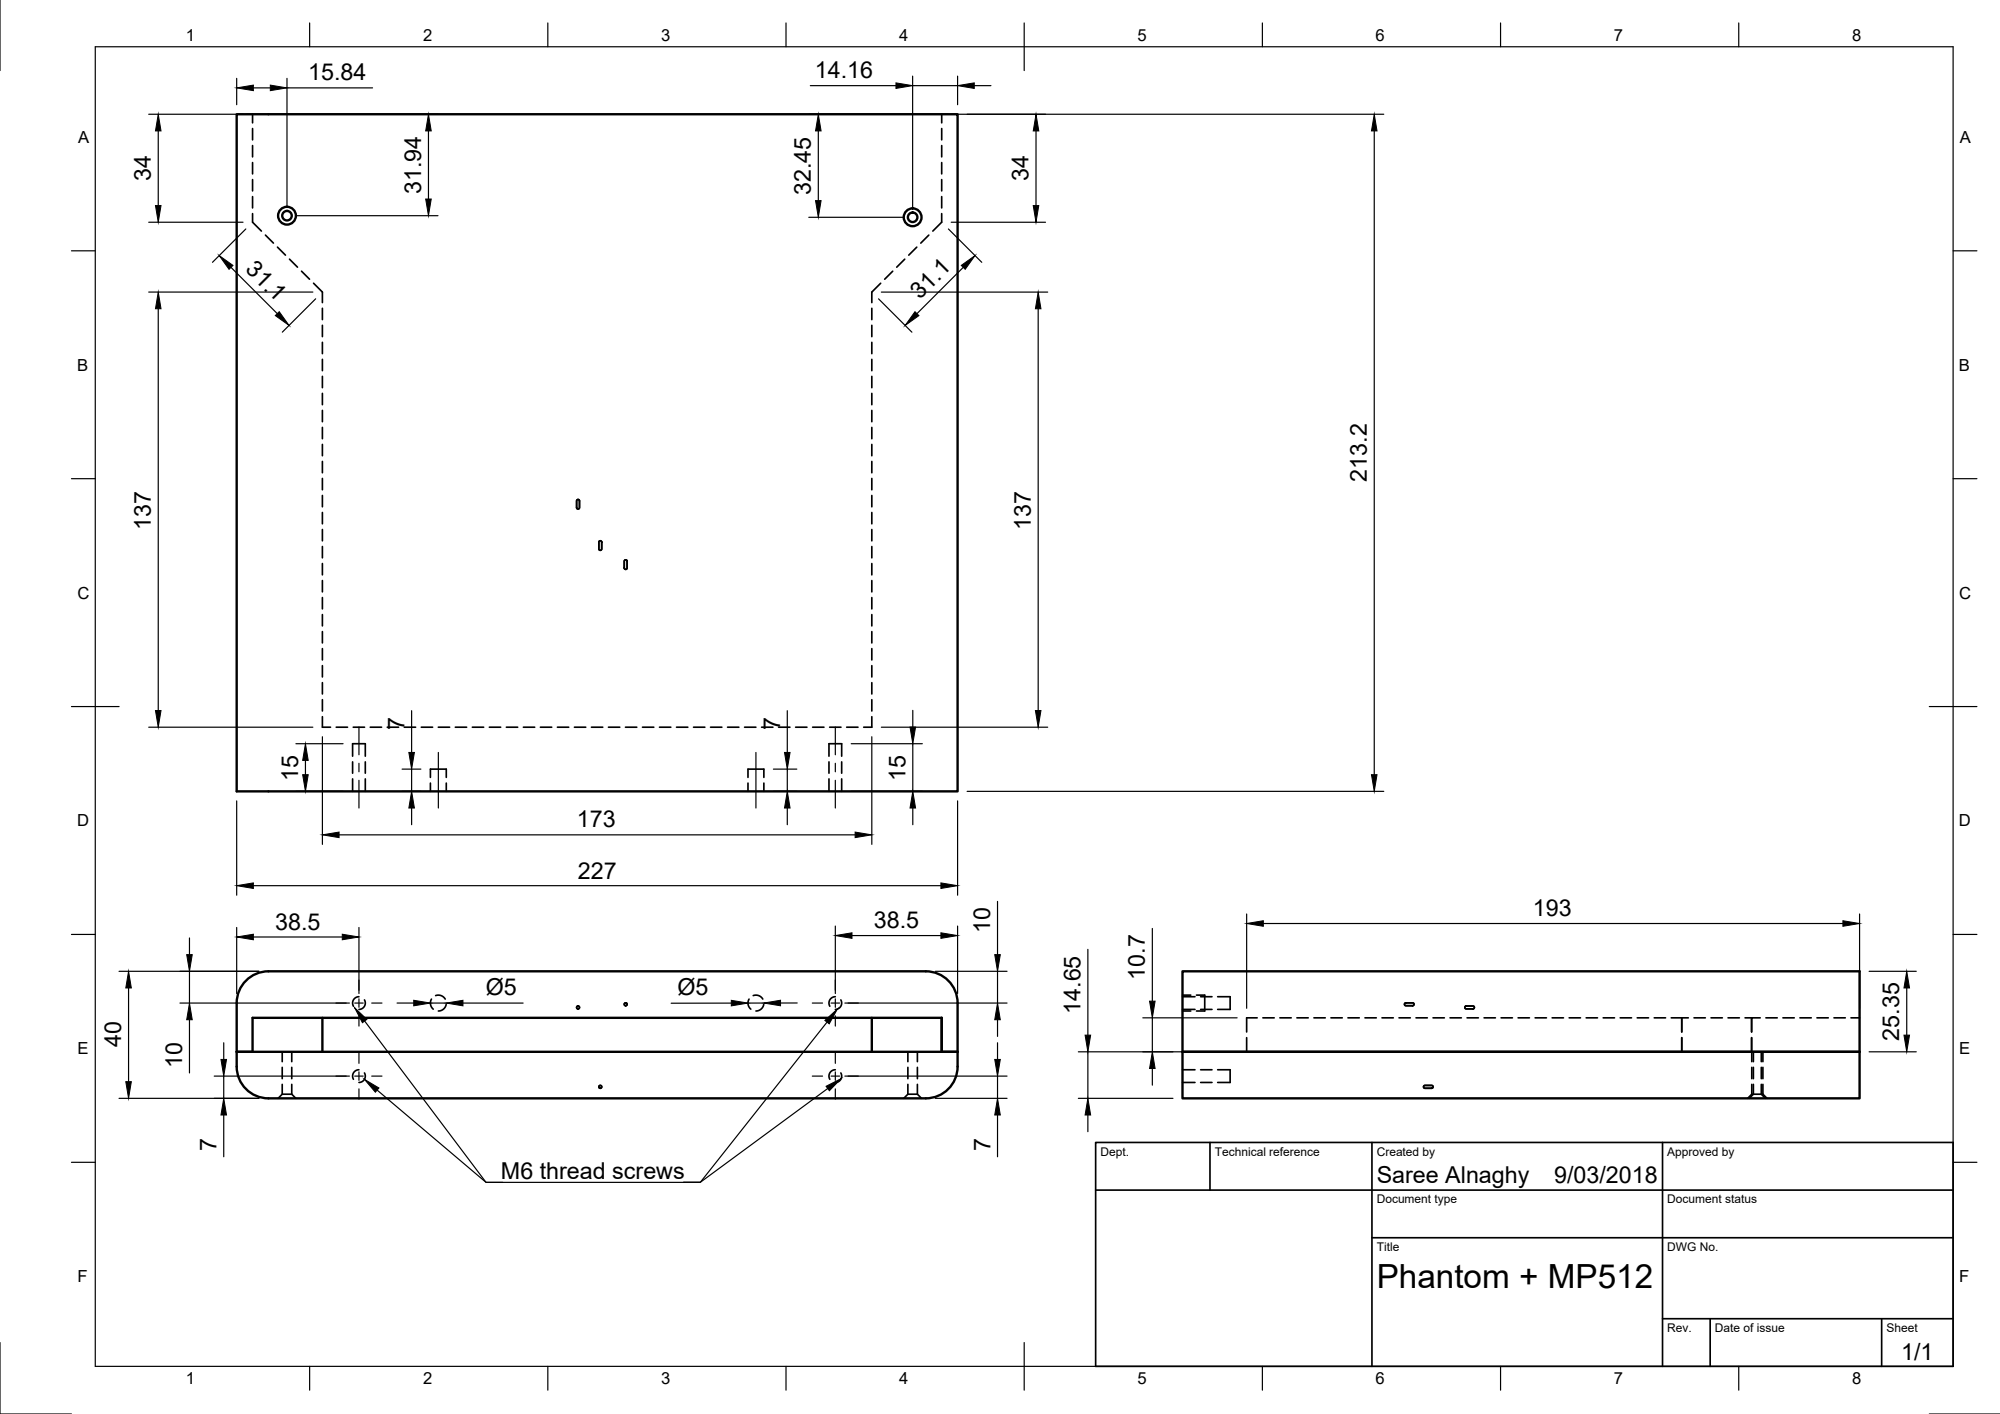
[picture p120: page 1]
Saree Alnaghy 213.2 34; M6 thread screws

Dept. | Technical reference | Created by 9/03/2018 | Approved by

Document type | Document status

Title Phantom + MP512 | DWG No.

Rev. | Date of issue | Sheet 1/1
