Image-X-Institute/IntERAct/Documentation/CAD Drawing of the phantom/Marker Phantom/Marker Phantom.pdf

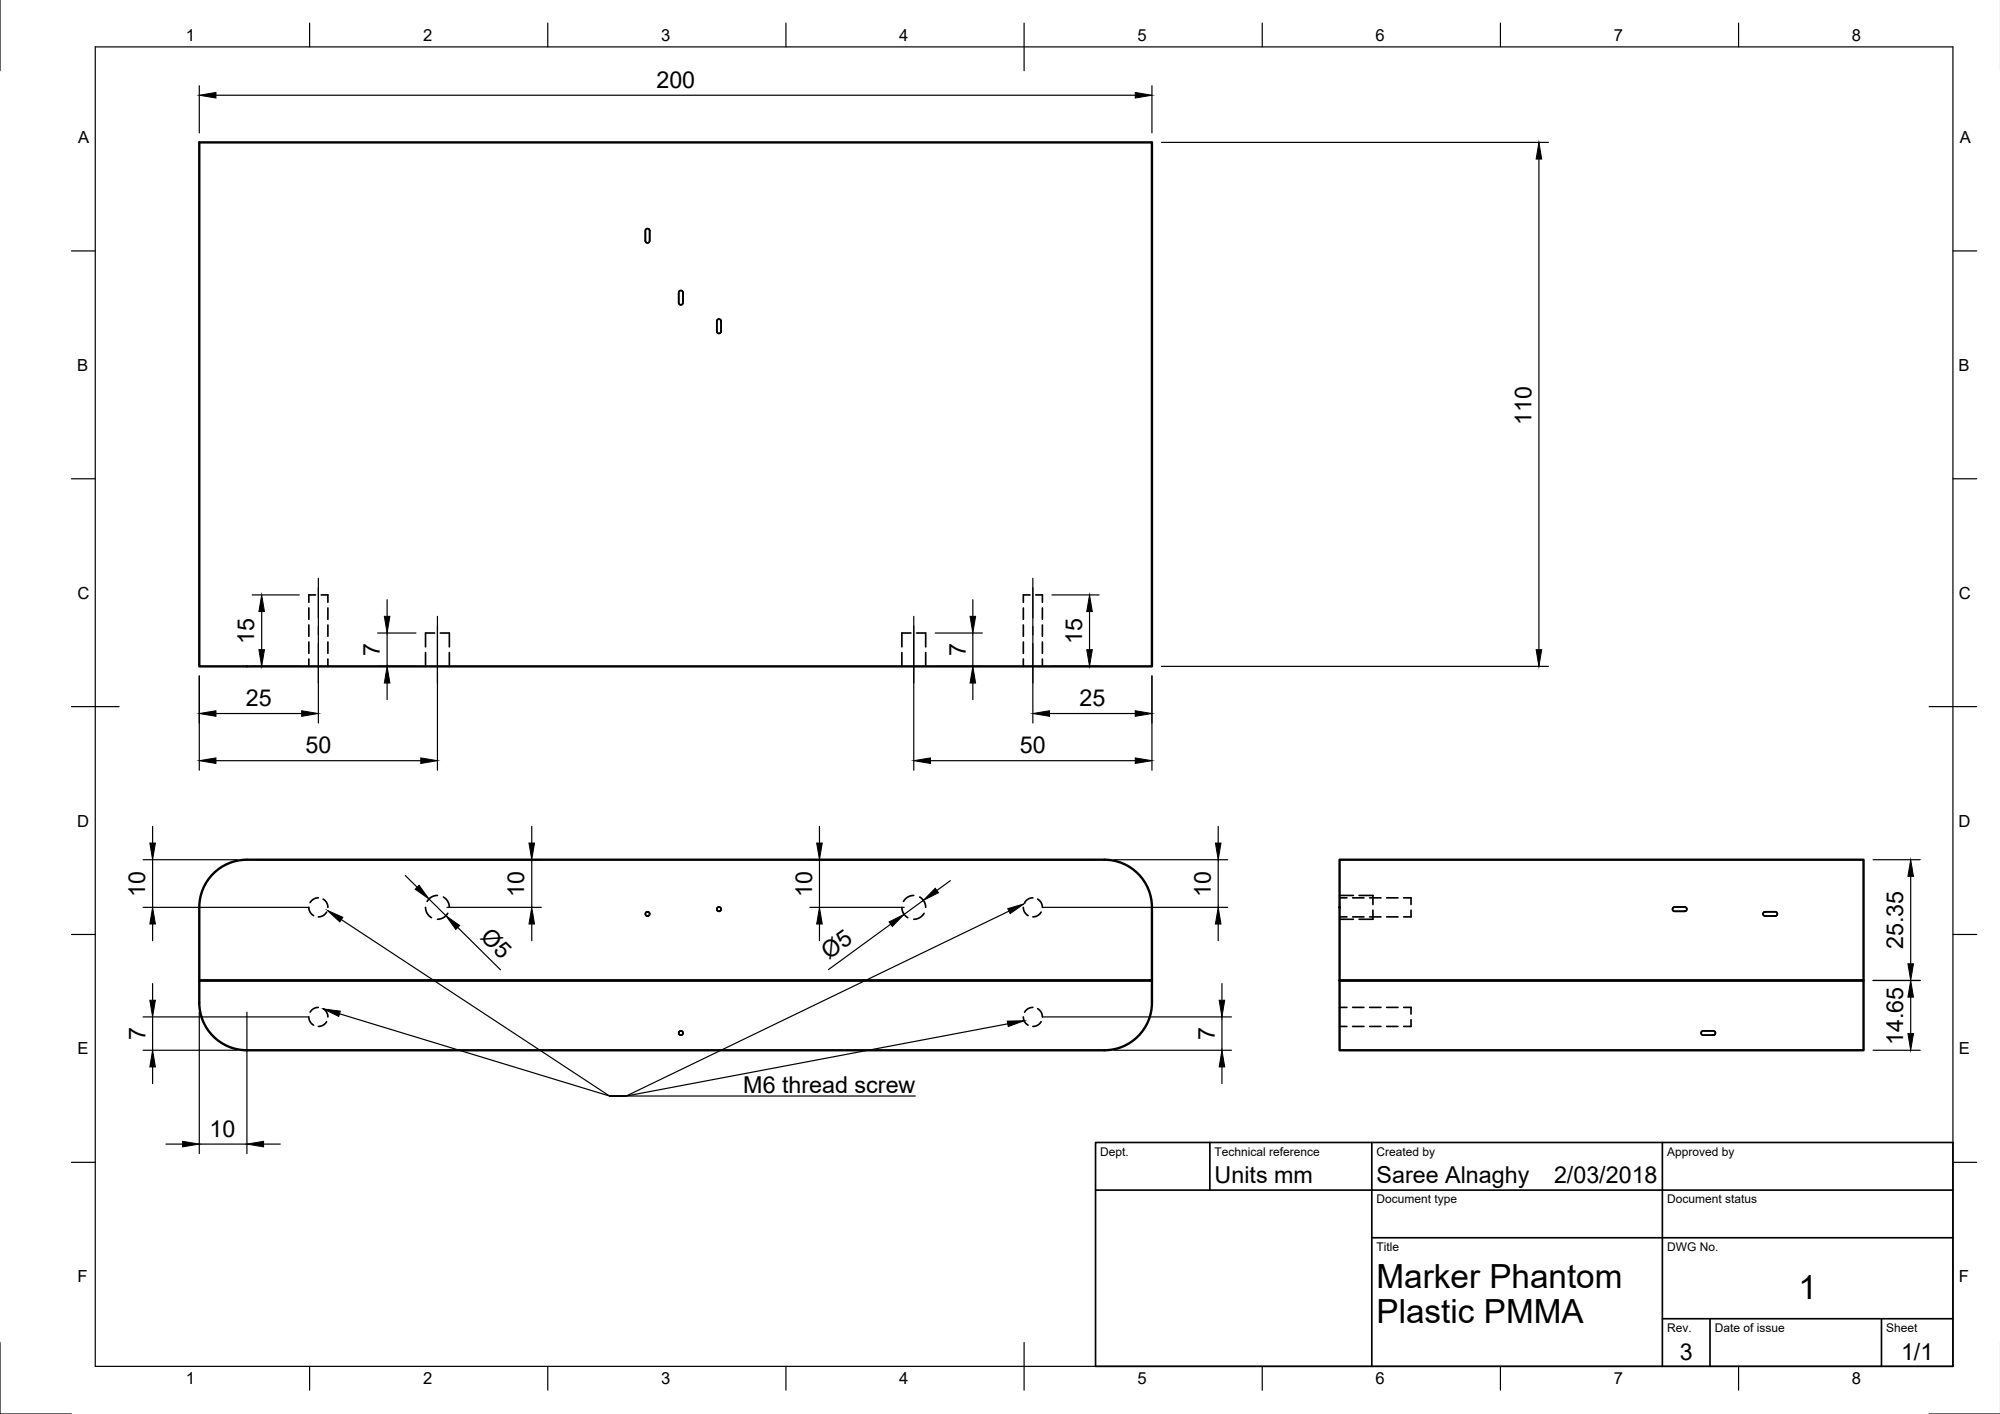
[picture p121: page 1]
M6 thread screw

Dept. | Technical reference Units mm | Created by Saree Alnaghy 2/03/2018 | Approved by

Document type | Document status

Title Marker Phantom Plastic PMMA | DWG No. 1

Rev. 3 | Date of issue | Sheet 1/1
