Image-X-Institute/IntERAct/Documentation/CAD Drawing of the phantom/Marker Phantom with Detector/Gold Marker.pdf

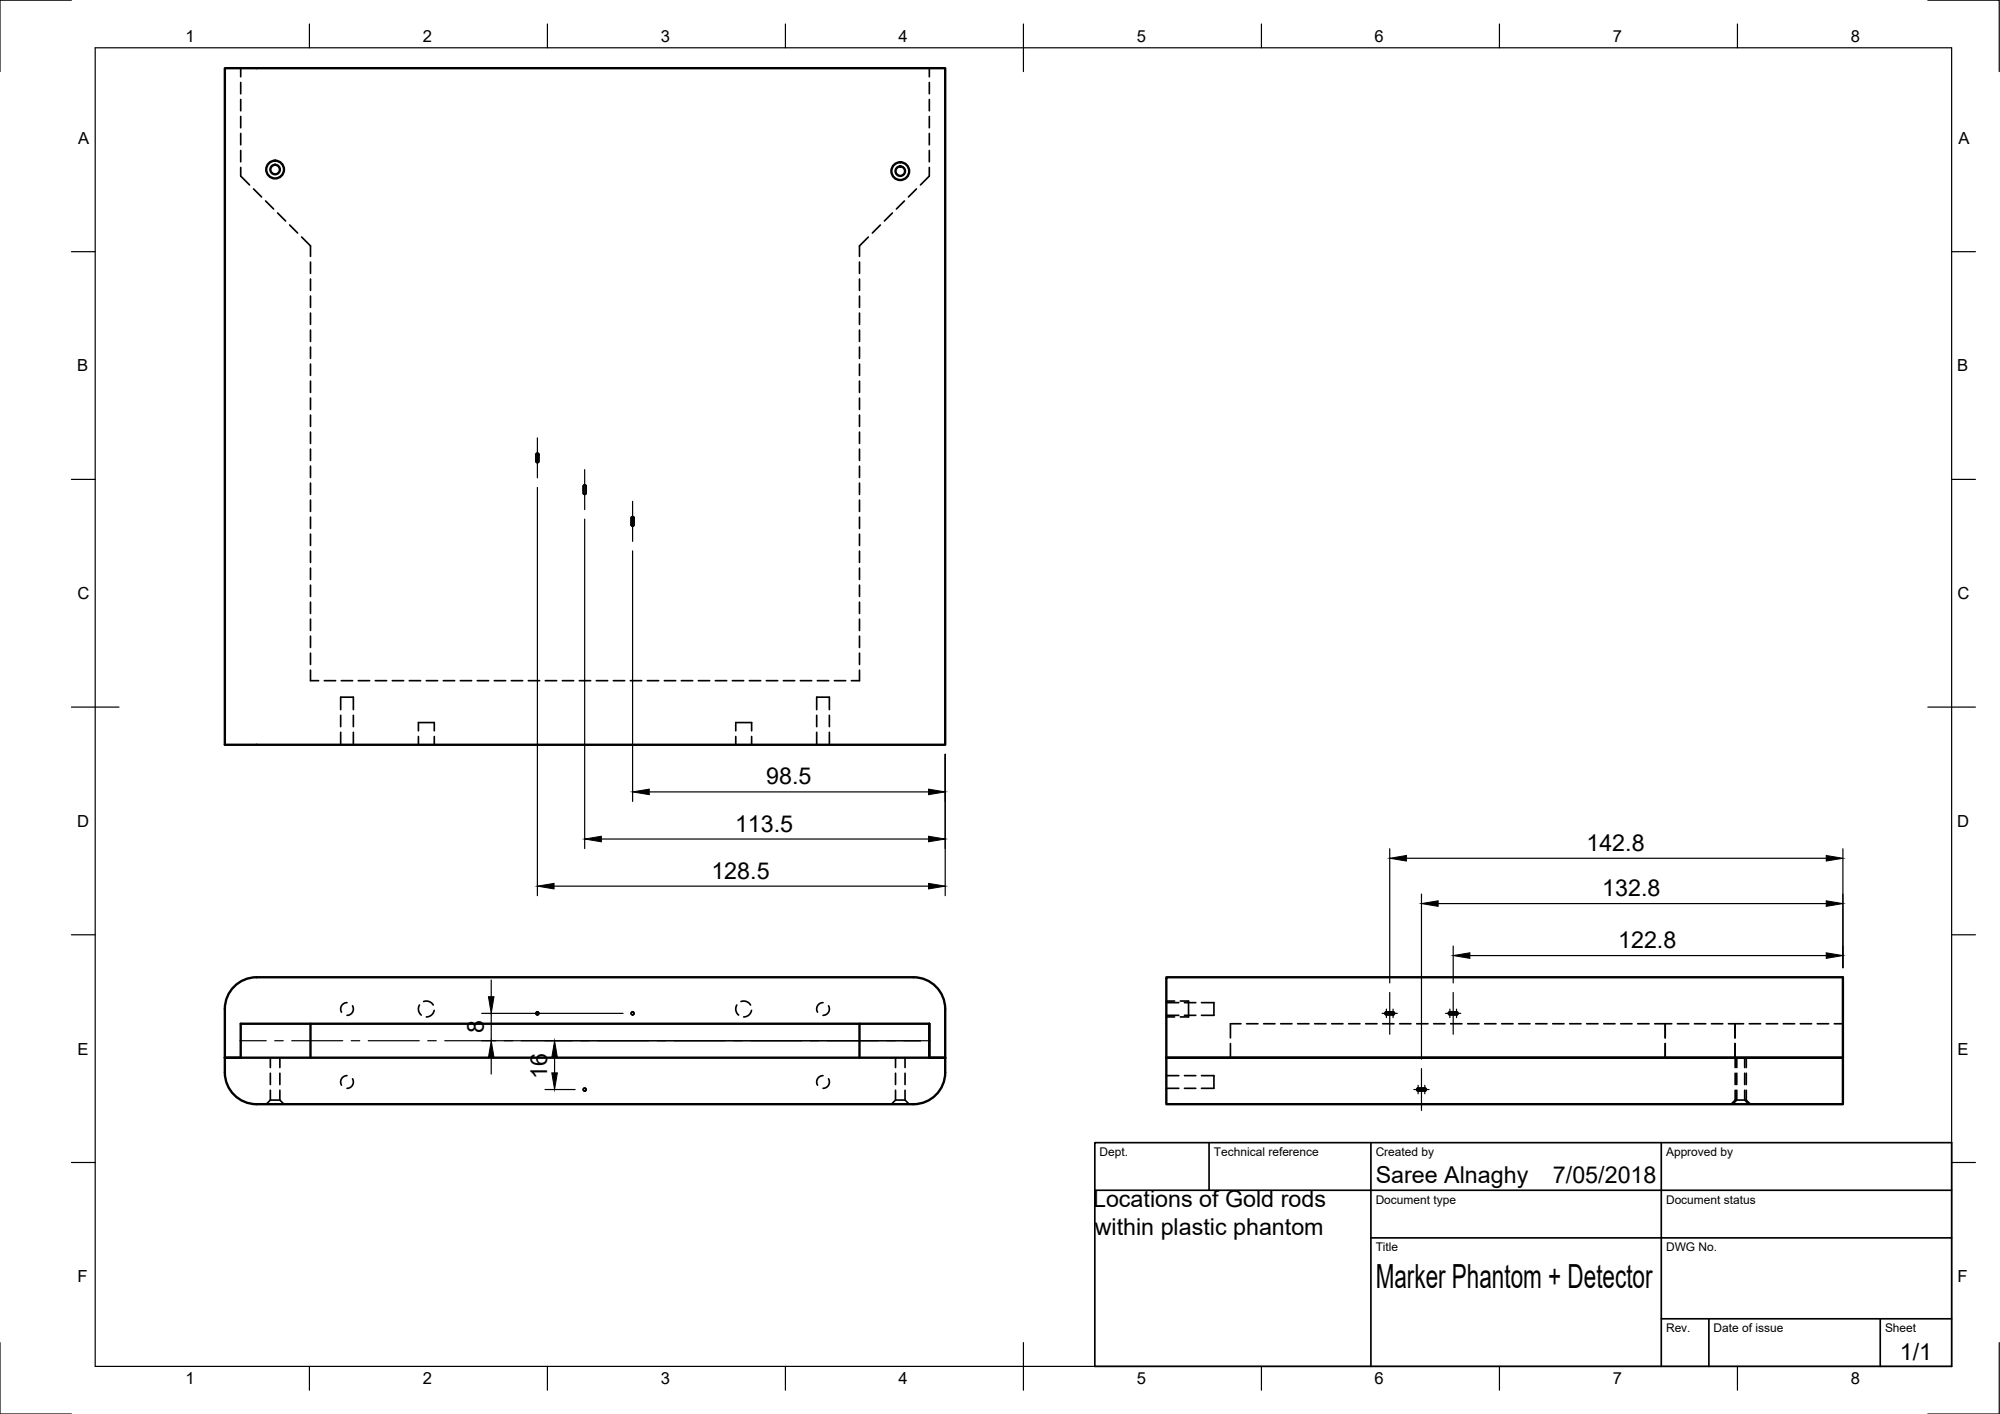
[picture p122: page 1]

Dept. | Technical reference | Created by Saree Alnaghy 7/05/2018 | Approved by

Locations of Gold rods within plastic phantom | | Document type | Document status

Title Marker Phantom + Detector | DWG No.

Rev. | Date of issue | Sheet 1/1
