Image-X-Institute/IntERAct/Documentation/CAD Drawing of the phantom/Marker Phantom/Gold Marker-Location.pdf

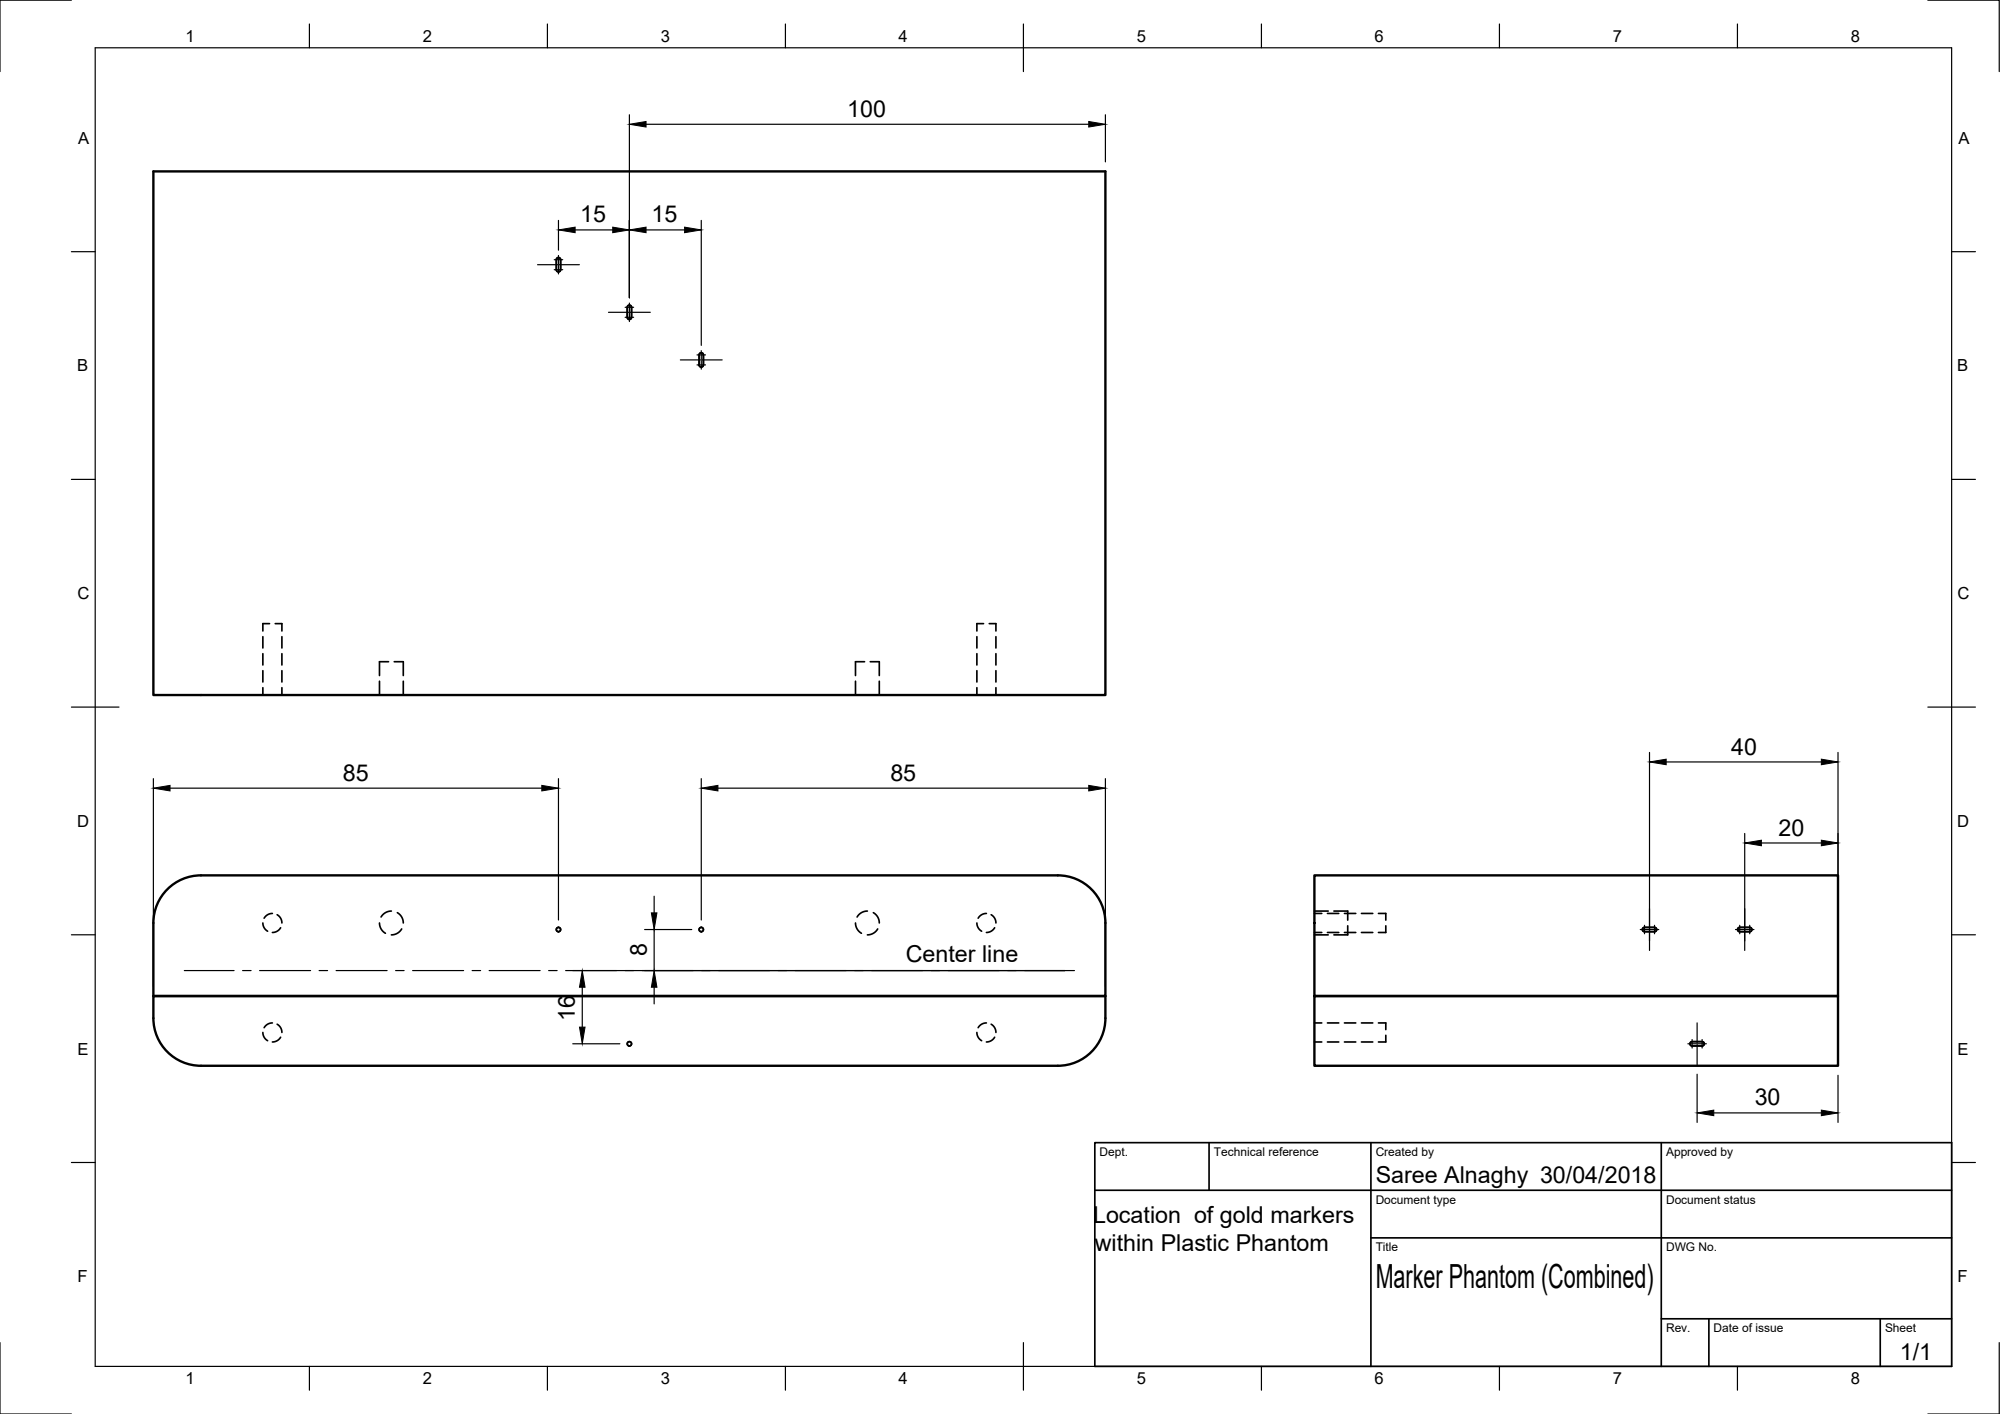
[picture p123: page 1]
8Center line 16

Dept. | Technical reference | Created by Saree Alnaghy 30/04/2018 | Approved by

Location of gold markers within Plastic Phantom | | Document type | Document status

Title Marker Phantom (Combined) | DWG No.

Rev. | Date of issue | Sheet 1/1
