Image-X-Institute/IntERAct/Documentation/CAD Drawing of the phantom/Marker Phantom/Marker Phantom Line etching location.pdf

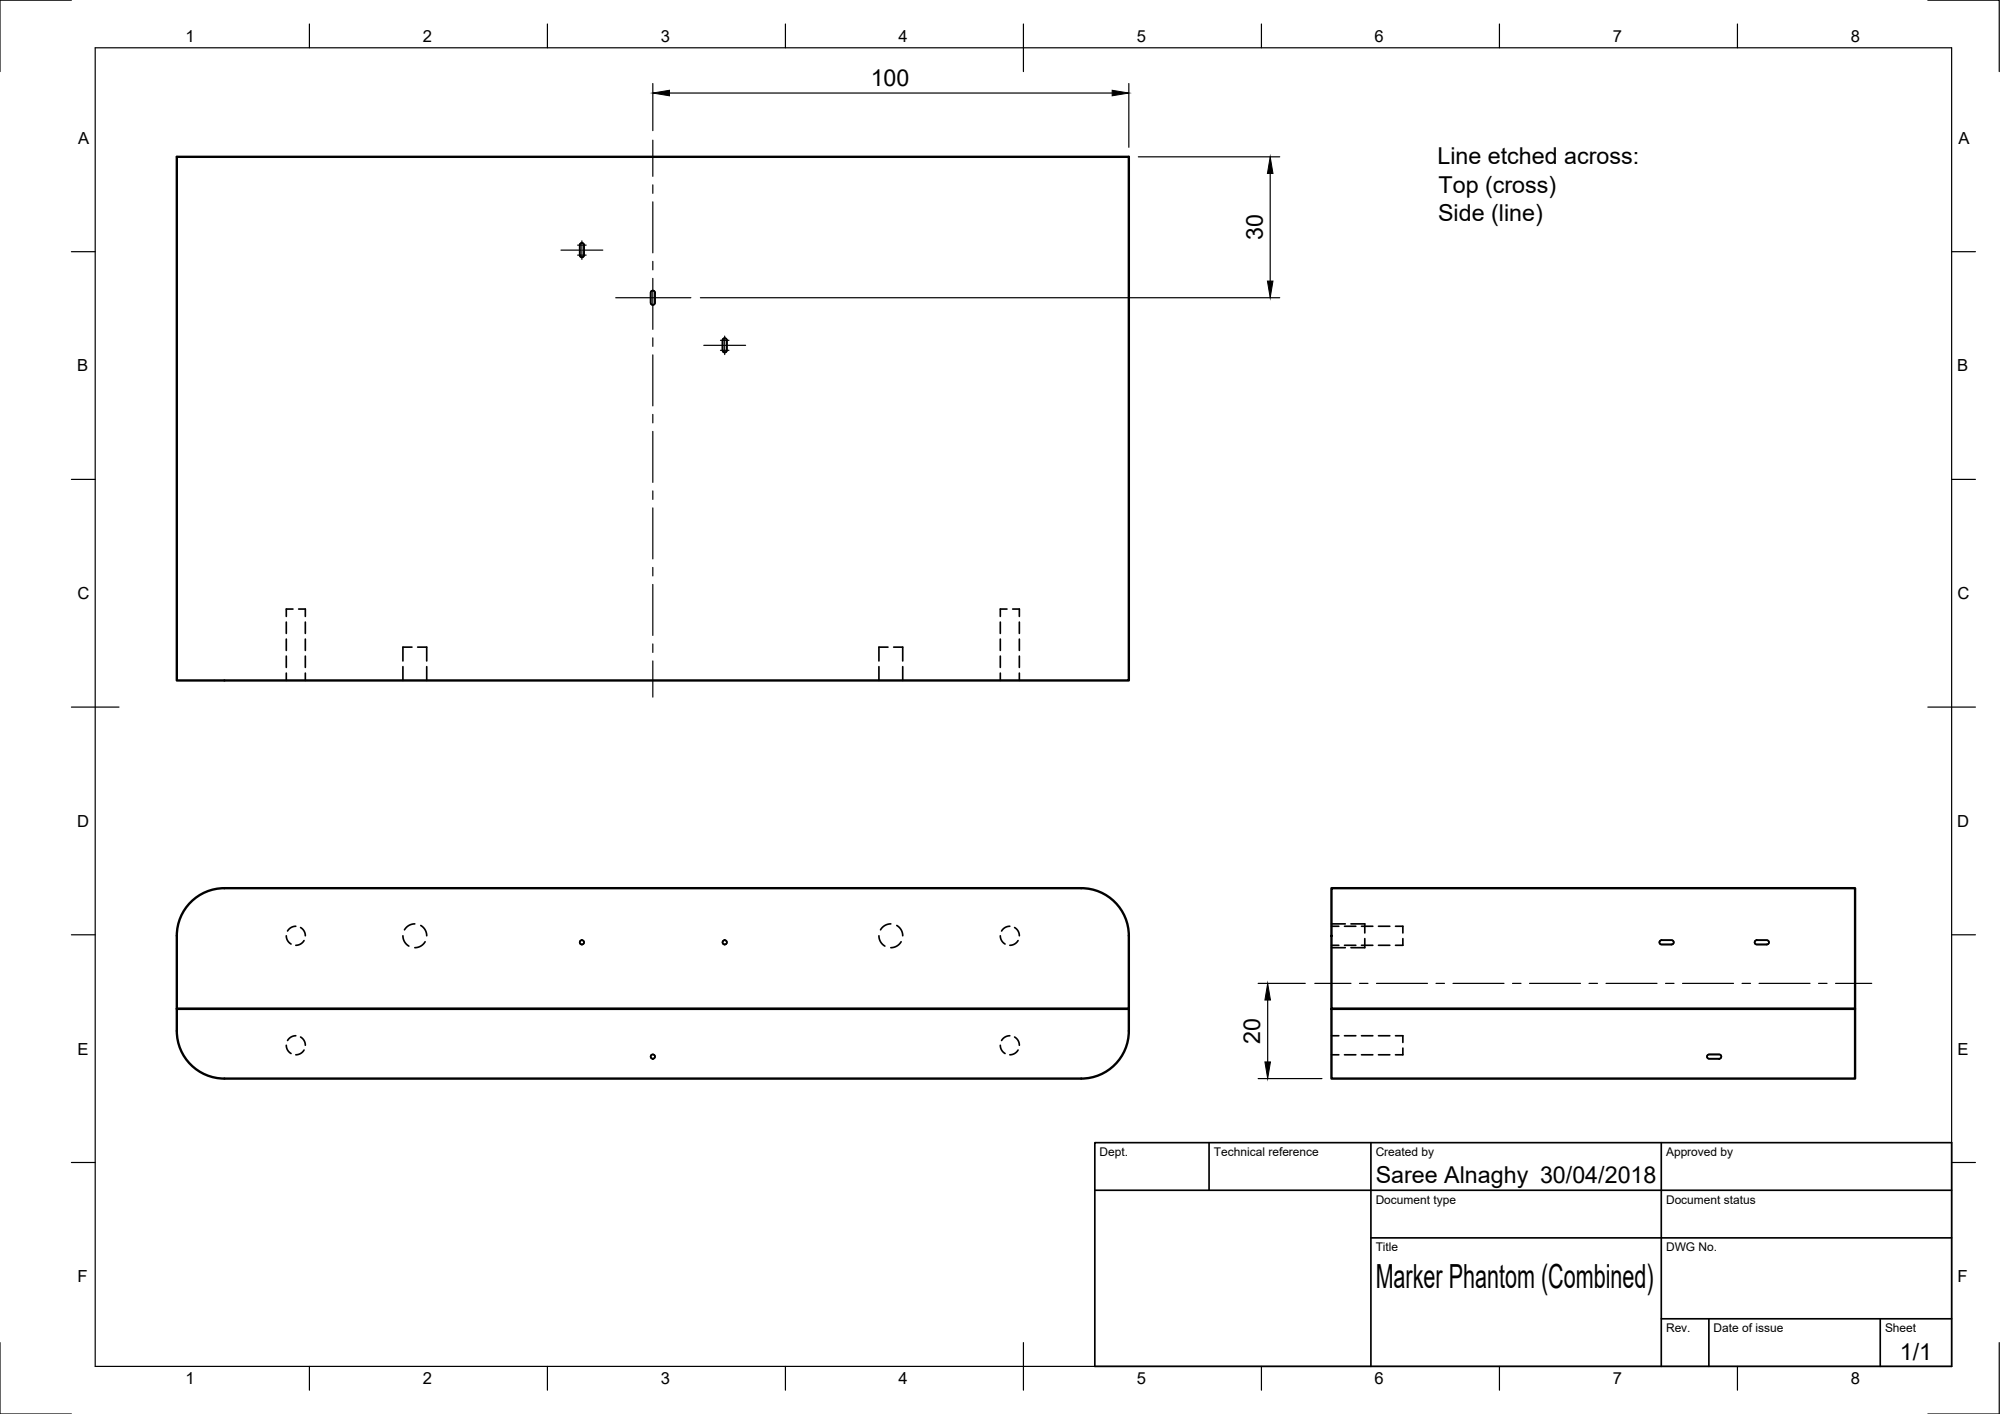
[picture p124: page 1]
Saree Alnaghy 30

Line etched across:
Top (cross)
Side (line)

Dept. | Technical reference | Created by 30/04/2018 | Approved by

Document type | Document status

Title Marker Phantom (Combined) | DWG No.

Rev. | Date of issue | Sheet 1/1
