Image-X-Institute/IntERAct/(commit log)

2021-02-06 CAD drawing of the tool flange holder
2021-02-06 CAD drawing of the phantom with fiducial markers
2021-02-06 CAD drawing of the marker phantom with detector
2021-02-06 CAD drawing of the markerless phantom without detector
2021-02-06 CAD drawing of the markerless phantom with detector
2021-02-06 CAD drawing of the markerless phantom
    CAD drawing of the markerless phantom with detector
2021-02-06 CAD drawing of the marker phantom without a detector
2021-02-06 CAD drawing of the marker phantom with a detector
2021-02-06 CAD drawing of the marker phantom without detector
2021-03-14 Bill of materials
2024-03-07 Upload -Traces
2024-03-07 Added Custom Traces
2024-03-07 Arduino IDE - 1D Code
2024-05-08 encoder and feedback are supported with limitations
2024-05-08 added encoder feedback display added displacement data sent to arduino controller, for the purpose of calibrating motor movement. in the corresponding arduino firmware code, we added encoder movement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
2024-05-08 Added encoder function to Arduino_V3.ino - show distance feedback from encoder - use distance feedback to calibrate motor motion.
2024-05-08 Arduino update
2024-06-12 UR16 phantom design
    [PhantomFrame-Flange.STEP]
2024-06-27 update stop/resume 1D
    [point_measurement.csv]
2024-06-30 Log + separate buttons stop and resume
2024-07-01 update 1/07/2024
    Changed the 1D delay for 300s traces
2024-07-08 6D resume function and query the controller task
    - Added the correct traveling time delay to plot sync the 6D trace when resume the motion.
    - Query the controller to run sync 1D and 6D -> need to do measurements
2024-07-11 1D mode configuration
    added a button to select the 1D configuration (vertical or horizontal)
2024-07-15 Sample rate 6DoF
    Loading the frequency from the input file and updating it in the interface. However, the user can still change manually the sample rate.
2024-08-21 Rename Documentation/Bill of materials.pdf to Documentation/6DoF/Bill of materials.pdf
2024-08-21 Rename Documentation/CAD Drawing of the phantom/Design details.docx to Documentation/CAD Drawing of the phantom/6DoF/CAD Drawing of the phantom/Design details.docx
2024-08-21 Create Arduino Wiring
2024-08-22 Rename feedback_linear_actuator_bb_c02ff28e-6ce0-43d5-962f-e740c6086a5e.webp to Arduino-1D Wiring Diagram.webp
2024-08-22 Rename sketch_test_horizontal.ino to voltage-motor speed relationship.ino
2024-08-22 Rename voltage-motor speed relationship.ino to voltage_motor_speed_relationship.ino
2024-12-06 Add files via upload
    Add updated circuit diagram using additional breadboard for connections.
2025-05-26 fix bug where there is a 30 seconds to 1.5 min delay between loading the traces and clicking play motion.
2026-04-14 Update to take maximum number of lines from input 6DoF file, from the settings.txt file
    [point_measurement.csv, time_array20260224_153903_analysis_flats.csv, time_array20260224_153903_analysis_ramps.csv, time_array20260224_153903_analysis_steps.csv, time_array20260224_154032_analysis_flats.csv, time_array20260224_154032_analysis_ramps.csv, time_array20260224_154032_analysis_steps.csv, time_array20260224_154116_analysis_flats.csv]
2026-04-15 fix bug - missing leading slash in log generation when input trace file exceeds 1MB
2026-04-15 Fix urScript file not found error on long traces: flush StreamWriter before FileInfo size check
2026-04-19 Improve frequency independence and fix segment duration for long traces
    The motion platform previously assumed a fixed 5 Hz (0.2s) sample rate throughout
    the codebase, with hardcoded values for timing, velocity calculation, and delay
    computation. These have been replaced with UrSettings.TimeKinematics, allowing
    input files at any sample rate (e.g. 20 Hz, 50 Hz) to be played correctly.
    The maximum input file line limit (previously a fixed line count read from
    settings.txt) has been replaced with a user-configurable segment duration in
    minutes. The segment size is now computed dynamically from the file's own sample
    rate, so long traces at any frequency are handled correctly. The new setting i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
2026-04-20 Fix small bug: allow traces exactly matching segment duration to play without segmenting into smaller sections.
    Previously, a trace equal in length to the configured segment duration could
    incorrectly trigger the segmented playback warning due to floating point
    precision in the sample count. Fixed by adding a one-sample tolerance to the
    segment size threshold.
2026-04-20 Fix real-time feedback plotting and crashes during segmented playback
    Long traces that exceeded the segment duration were crashing the software
    and failing to plot robot feedback in real time, despite the robot motion
    itself running correctly. The root causes were a combination of threading
    issues in the segmented playback path.
    Heavy work (MODBUS register conversion, coordinate transforms, safety
    checks) was being done on the UI thread inside the monitor's Invoke block,
    which saturated the UI thread and prevented plot updates from rendering.
    This work has been moved to the background thread, with only the minimal
    chart and control updates marshalled to the UI thread via BeginInvoke.
    The a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
